Vanperdung/Mandevices_GPS_GSM/Document/stm32f103 pinout.jpg

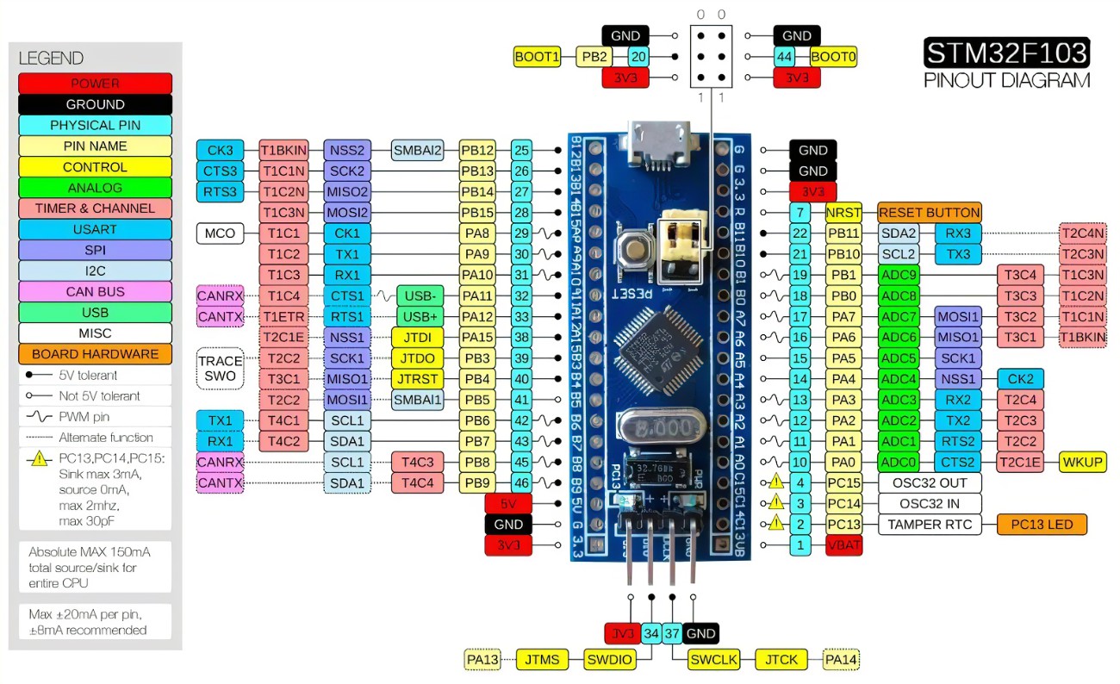
Document/stm32f103 pinout.jpg
