Vanperdung/Mandevices_GPS_GSM/HARDWARE/MandevicesGPSGSM/PCB1.PcbDoc.htm

Reporting Options

# File in Previous Format

Date | : | 3/28/2022
Time | : | 7:57:32 PM
Filename | : | D:\Mandevices_GPS_GSM\Mandevices_GPS_GSM\Hardware\MandevicesGPSGSM\PCB1.PcbDoc

Version | Warning

This file was generated by an earlier version of the software
