Vanperdung/Mandevices_GPS_GSM/Document/so-do-mach-USB-to-TTL-CH340G.png

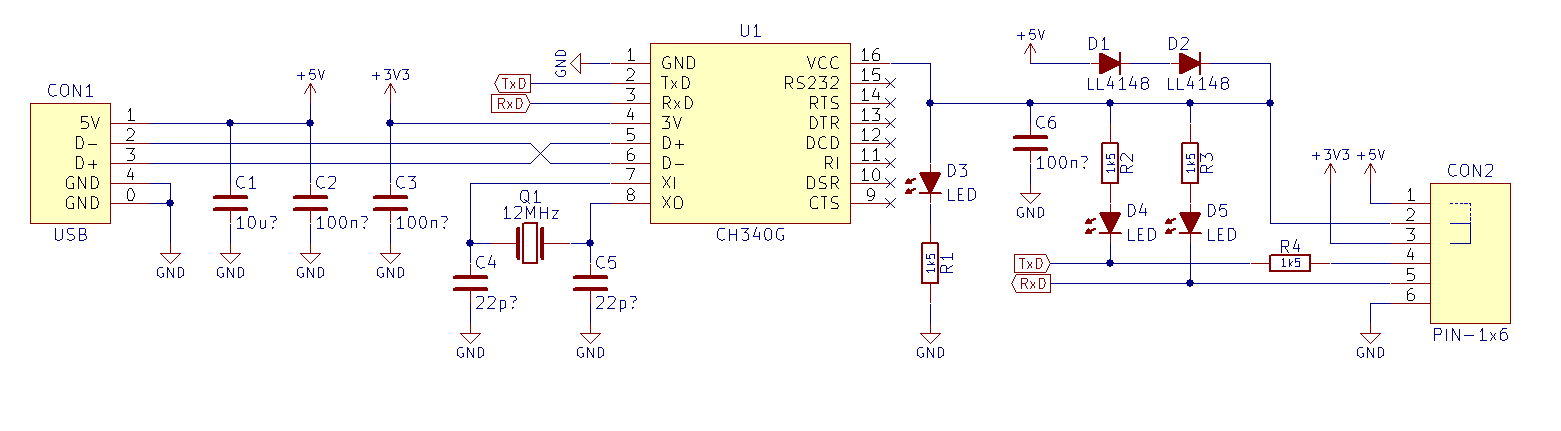
Document/so-do-mach-USB-to-TTL-CH340G.png
