Vanperdung/Mandevices_GPS_GSM/Document/DATN-master/List linh kien/BOM List - New.xlsx

Comment | Description | Designator | Footprint | LibRef | Quantity | Check | Còn lại | Cần mua thêm | Nơi mua | Mã SP | ghi chú
PIN 3V | Battery 3VDC | BT1, BT2 | CR1220 SMD | PIN 3V | 2 | v | 0 | 2 | lkcl | PIN0001 | cái
100uF/100V | Cap 100uF/35V - 470uF/16V | C1, C2 | CP1.5/3.4 | CP3 | 2 | v | 2 | 2 | lkcl | CLA4515 | cái
5D330K 33V | 5D330K 33V | C3 | CN2 | CN | 1 | v | 6 | 0 |  |  | cái
104 | Cap SMD | C4, C20, C22, C24, C26, C28, C31, C38, C48, C53 | C0603 SMT | CM_1, CM | 10 | v |  | 2 | lkcl | CLA4098 | dây 10 con
47uF | Cap SMD | C5, C6 | SM-1210 | CM_1 | 2 | v | 3 | 2 | cxt | A072302 | con
1uF | Cap SMD | C7, C8, C35, C36, C37, C40 | CAP_0805 | CM_1, CM | 6 | v |  | 1 | lkcl | CLA3548 | dây
2.2uF/100V | CAP CER 2.2UF 100V X7R 1210 445-4498-2-ND | C9, C10, C13 | SM-1210 | CM | 3 | v | 2 | 5 | cxt | A101901 | con
39pF | Cap SMD | C11 | CAP_0805 | CM_1 | 1 | v | nhiều
6800pF | Cap SMD | C12 | CAP_0805 | CM_1 | 1 | v | nhiều
104 | Cap SMD | C14, C44, C46, C52, C54 | CAP_0805 | CM_1, CM | 5 | v | nhiều
10uF/25V | Cap SMD | C15, C16 | CAP_0805 | CM_1 | 2 | v | 1 | 1 | lkcl | CLA4020 | dây 10 con
10uF/16V | Cap SMD | C17, C18 | CAP_0805 | CM_1 | 2
1uF | Cap SMD | C19, C32 | C0603 SMT | CM | 2 | v | 1 | 1 | lkcl | CLA4103 | dây 10 con
10uF | Cap SMD | C21, C23, C25, C27 | C0603 SMT | CM | 4 | v | 0 | 1 | lkcl | CLA4107 | dây 10 con
22pF | Cap SMD | C29, C30, C47 | C0603 SMT | CM | 3 | v | nhiều
10pF | Cap SMD | C33, C34 | C0603 SMT | CM | 2 | v | 0 | 1 | lkcl | CLA1296 | dây 10 con
2.2uF | Cap SMD | C39 | RES-SMD-1210 | CM | 1
470uF/6V3 | Cap Aluminum | C41, C42 | C_Alu_6.3x7.7 | C-Alu-Tantalum | 2 | v | 0 | 4 | lkcl | CLA1037 | cái
100uF/16V | Cap Tantalum 7343 | C43 | C_7343_40 | C-Alu-Tantalum | 1 | v | 1 | 2 | lkcl | CLA1291 | cái
10nF | Cap SMD | C45 | CAP_0805 | CM | 1 | v | nhiều
NM | Cap SMD | C49, C50 | C0603 SMT | CM | 2
4.uF | Cap SMD | C51 | SM-1210 | CM | 1 | v | 0 | 2 | cxt | A132403 | con
10uF | Cap SMD | C52 | CAP_0805 | CM | 1
100pF | Capacitor, Cap SMD | C55, C56 | CAP_0805 | CapSMD, CM | 2 | v | 0 | 1 | lkcl | CLA1309 | dây 10 con
B560C-13-F | DIODE SCHOTTKY 60V 5A SMC | D1, D3 | DO-214AB SMC | D5A | 2 | v | 0 | 4 | banlinhkien |  | con | https://banlinhkien.com/diode-ss56-5a-60v-smc-do214ab-p12911888.html
B340-13-F | DIODE SCHOTTKY 40V 3A SMC, Diode 1A | D2, D9, D10 | DO-214AB SMA | D1A | 3 | v | 0 | 10 | lkcl | CLA2548 | con
PWR_12V | LED Single colour Green and Red | D4 | LED-0805-Yellow | LED | 1 | v | 1 |  |  |  | dây 10 con
PWR_4V | LED Single colour Green and Red | D5 | LED-0805-Green | LED | 1 | v | 1 |  |  |  | dây 10 con
DIODE-BAV99 | ZENER, SOT23, | D6, D7, D11 | SOT23 | DIODE-BAV99 | 3 | v | 7 | 10 | lkcl | CL00319 | con
V_IN | LED Single colour Green and Red | D8 | LED-0805-Red | LED | 1 | v | nhiều
RKEF300HF-ND | PTC RESET FUSE 60V 3A RADIAL | F1 | FUSE2 | Fuse | 1 | v | 2
F1A | Fuse | F2 | RES-SMD-1812 | Fuse | 1 | v | 0 | 2 | lkcl | CLA1687 | cái
BLM21PG600SN1D | Ferrite Bead | FB1, FB2, FB3, FB4, FB5 | R0805 | Ferrite Bead | 5 | v | 0 | 2 | lkcl | CLA3470 | dây 10 con
watdog | Jumper 2 | J1 | JP2 | JP 2 | 1
ST_LINK | Header IDC, 4 x 1 Pin Vertical 2.54mm Pitch (Non-Boxed, Male) | J2 | CON_4P | Header4 | 1
BOOT | Connector 3x2 | J3 | JP3x2 | JP3x2 | 1
DEBUG | Jumper 3 | J4 | JP3 | JP3 | 1
GPS_ANTENNA |  | J5, J9 | Antenna-MCX5.08-H5 | ANTEN | 2 | v | 0 | 4 | lkcl | CLA5149 | cái
GSM |  | J6 | Antenna-IPEX | ANTEN | 1
SIM MICRO PUSH |  | J7 | MICRO_SIM_HOLDER | SIM MICRO PUSH | 1 | v | 2
RS485 | Header 2 (Green) | J10 | Hed2V_3.96 | Hed2 | 1 | v | 0 | 2 | lkcl | CLA3094 | cái
PWR | Header 4 (Green) | J11 | Hed4V_3.96 | Hed4 | 1 | v | 0 | 2 | lkcl | CLA3093 | cái
PWR OUT | Connector 4 | J12 | CON_2.54mm_4 | Con4 | 1
NPN_SENSOR | Connector 4 | J13 | CON_2.54mm_4 | Con4 | 1
V_IN | Connector 2 | J14 | CON_2.54mm_2 | Con2 | 1
Header3 | Header IDC, 3 x 1 Pin Vertical 2.54mm Pitch (Non-Boxed, Male) | J15 | Header3 | Header3 | 1
DHT11 |  | J16 | DHT11 | DHT11 | 1
L | Inductor | L1 | L2 UF9.8 | L2x220 | 1 | v | 3
6.8uH | FIXED IND 6.2UH 5.7A 22.4 MOHM | L2 | L01 SMD 12*12*6 | L1 | 1 | v | 0 | 2 | lkcl | CLA2641 | cái
47nH | Inductor | L3 | C0805 | L1 | 1 | v | 1 |  |  |  | dây 10 con
100uH | 100uH 0805 | L4 | R0805 | Ferrite Bead | 1
OLED 1.3 |  | LCD1 | OLED 1.3 | OLED 1.3 | 1
LED | LED Single colour Green and Red | LED1 | LED-0805-Green | LED | 1
LED | LED Single colour Green and Red | LED2 | LED-0805-Yellow | LED | 1
LED | LED Single colour Green and Red | LED3 | LED-0805-Red | LED | 1
SIM800C |  | M1 | SIM800C | SIM800C | 1 | v | 2
C1815 | NPN 600mW, ECB | Q1, Q2, Q3, Q4, Q5, Q6 | SOT23B | C1815 | 6 | v | 4 | 10 | lkcl | CL00356 | cái
10K | Resistor SMD | R1, R3, R7, R19, R28, R29, R30, R55, R59, R60 | RES-SMD-0805 | RM | 10
22K | Resistor SMD | R2, R4 | RES-SMD-0805 | RM | 2
100K | Resistor SMD | R5, R8, R9, R41, R42 | RES-SMD-0805 | RM | 5
1K | Resistor SMD | R6, R13, R14, R15, R16, R36, R39, R40, R43, R61 | RES-SMD-0805 | RM | 10
4.7K | Resistor SMD | R10, R62, R65 | RES-SMD-0805 | RM | 3
47K | Resistor SMD | R11 | RES-SMD-0805 | RM | 1
4k7 | Resistor SMD | R12 | RES-SMD-0805 | RM | 1
0R | Resistor SMD | R17, R52, R56, R58 | RES-SMD-0805 | RM | 4
10R | Resistor SMD | R18, R23, R25 | RES-SMD-0805 | RM | 3
22R | Resistor SMD | R20, R26 | RES-SMD-0603 | RM | 2 | v | 0 | 1 | lkcl | CLA3271 | dây 50 con
10K | Resistor SMD | R21, R22, R53, R54 | R0603 -SMT | RM | 4
10K | Resistor SMD | R24 | RES-SMD-0603 | RM | 1
1k | Resistor SMD | R27 | RES-SMD-0603 | RM | 1
1K | Resistor SMD | R31, R35, R37, R49, R50 | R0603 -SMT | RM | 5
47K | Resistor SMD | R32, R51 | R0603 -SMT | RM | 2
4.7K | Resistor SMD | R33, R34, R38 | R0603 -SMT | RM | 3
51R | Resistor SMD | R44, R45, R46 | R0603 -SMT | RM | 3
0R | Resistor SMD | R47, R48 | R0603 -SMT | RM | 2
120R | Resistor SMD | R57 | RES-SMD-0805 | RM | 1
1K 1% | Resistor SMD | R63 | RES-SMD-0805 | RM | 1
10K 1% | Resistor SMD | R64 | RES-SMD-0805 | RM | 1
10k | Resistor SMD | R66 | R0805 | RM | 1
RFID |  | RFID1 | RFID RC522 | RFID RC522 | 1 | v | 1
SW-SMD | Switch | S1 | SW-SMD | SW-SMD | 1 | v | 9
SW-SMD | Switch | S2, S3, S4 | BUTTON NGHIENG | SW-SMD | 3 | v | 0 | 10 | lkcl | CLA4187 | con
TLV70233DBVT |  | U1 | TLV70233_3.3V | TLV70233_3.3V | 1 | v | 1 | 1 | cxt | A041602 | con
TPS54360DDA | REG BUCK SPLIT RAIL 8SOPWRPAD | U2 | DDA8_3P1X2P4-M | TPS54360DDA | 1 | v | 2
TLV1117-33CDCYR | 3v3 | U3 | SOT223-4N | LM1117 | 1 | v | nhiều
LM7812SX/NOPB | LM7812SX/NOPB | U4 | TO-263-4 | LM78xx_1 | 1 | v | 3
78M05 | On ap +, from + 5 to + 24VDC | U5 | TO252-3L | LM78xx | 1 | v | 2
STM32F103RCT6 | MCU 32BIT 256KB FLASH 64LQFP | U6 | LQFP-64 | STM32F103RCT6 | 1 | v | 2 |  |  |  |  | thay bằng stm32f107rc
TPS3828 |  | U7 | TPS3828 | TPS3828 | 1
SRV05 | TVS DIODE 5V | U8 | SOT23-6 | SRV05 | 1 | v | 4
GPS L70 |  | U9 | GPS L70 | GPS L70 | 1 | v | 2
SMF05C | ESD Protection | U10 | SOT_363_6 | SMF05C | 1 | v | 0 | 2 | cxt | A071806 | con
AT24C256 |  | U11 | SO-8 | AT24Cxx | 1 | v | 1
SN75176A |  | U12 | SN75176A | SN75176A | 1 | v | 4
PC817 | Single Opto | U13 | DIP4/W0.3 | PC817 | 1 | v | 0 | 2 | lkcl | CL00800 | con
USB |  | USB | USB-B-Mini | USB-M | 1 | v | 0 | 4 | lkcl | CLA1971 | con
32,768 Khz | Crystal 32,768kHz for timer real | X1 | XT32kn | XT32k | 1 | v | 0 | 2 | lkcl | CLA1612 | con
8MHz | CRYSTAL 16MHZ 18PF SMD | Y1 | ABM7_v1_1_BIG | ABM7-16.000MHZ-D2Y-T | 1 | v | 4
