Vanperdung/Mandevices_GPS_GSM/Document/DATN-master/List linh kien/BOM list.xlsx

Comment | Description | Designator | Footprint | LibRef | Quantity | Check | Price | total Price | link | note | code | Số lượng | Cửa hàng
PIN 3V | Battery 3VDC | BT1, BT2 | CR1220 SMD | PIN 3V | 2 | ok | VND 3000 | VND 6000 | http://linhkienchatluong.vn/pin-cac-loai/pin-cr1220-lithium_sp540_ct5222.aspx | Pin Cr1220 smd | PIN0071 | 2 cái | lkcl
100uF/100V | Cap 100uF/35V - 470uF/16V | C1, C2 | CP1.5/3.4 | CP3 | 2 | ok | VND 500 | VND 1000 | http://linhkienchatluong.vn/tu-hoa-co-phan-cuc/tu-hoa-35v-100uf-6x12mm-tan-so-cao_sp454_ct928.aspx | tụ hóa 100uf/35v | CLA0955 | 2 con | lkcl
5D330K 33V | 5D330K 33V | C3 | CN2 | CN | 1 | ok | VND 1000 | VND 1000 | http://linhkienchatluong.vn/tu-chong-set---varistor/tu-chong-set-varistor-5d330k-33v-5mm_sp1161_ct7521.aspx | varistor 5d330k 33V | CLA1205 | 1 con | lkcl
104 | Cap SMD | C4, C20, C22, C24, C26, C28, C31, C43, C47, C48 | C0603 SMT | CM_1, CM | 10 | ok | VND 200 | VND 2000 | http://linhkienchatluong.vn/tu-dan-060308051206/tu-dan-0603-du-gia-tri-tu-1pf-den-22uf-10c_sp1063_ct7503.aspx | tụ 0603 104 | CLA4098 | 1 dây 10 con | lkcl
47uF | Cap SMD | C5, C6 | SM-1210 | CM_1 | 2 | ok | VND 1500 | VND 3000 | https://linhkien.cxt.vn/2518-tu-47uf-10v-1210.html | Tụ 47uF SMD1210 | A072302 | mua 5 con | cxt | v
1uF | Cap SMD | C7, C8, C35 | CAP_0805 | CM_1, CM | 3 | ok | VND 350 | VND 1050 | http://linhkienchatluong.vn/tu-dan-060308051206/tu-dan-0805-du-gia-tri-tu-1pf-den-10uf-10c_sp1063_ct7504.aspx | tụ 0805 1uF | CLA3548 | 1 dây 10 con | lkcl
2.2uF/100V | CAP CER 2.2UF 100V X7R 1210 445-4498-2-ND | C9, C10, C13 | SM-1210 | CM | 3 | ok | VND 1000 | VND 3000 | https://linhkien.cxt.vn/4174-tu-22uf-50v-1210.html | tụ 2.2uF SMD1210 | A101901 | mua 5 con | cxt | v
39pF | Cap SMD | C11 | CAP_0805 | CM_1 | 1 | ok | VND 400 | VND 400 | https://banlinhkien.com/tu-0805-39pf-5-50v-10c-p8232171.html | tụ 0805 39pF | MH009986 | 1 dây 10 con | minhha
6800pF | Cap SMD | C12 | CAP_0805 | CM_1 | 1 | ok | VND 200 | VND 200 | http://linhkienchatluong.vn/tu-dan-060308051206/tu-dan-0805-du-gia-tri-tu-1pf-den-10uf-10c_sp1063_ct7504.aspx | tụ 0805 6.8nF | CLA3538 | 1 dây 10 con | lkcl
104 | Cap SMD | C14, C39, C41, C49 | CAP_0805 | CM_1, CM | 4 | ok | VND 300 | VND 1200 | http://linhkienchatluong.vn/tu-dan-060308051206/tu-dan-0805-du-gia-tri-tu-1pf-den-10uf-10c_sp1063_ct7504.aspx | tụ 0805 100nF - 104 | CLA3544 | 1 dây 10 con | lkcl
10uF/25V | Cap SMD | C15, C16 | CAP_0805 | CM_1 | 2 | ok | VND 500 | VND 1000 | http://linhkienchatluong.vn/tu-dan-060308051206/tu-dan-0805-du-gia-tri-tu-1pf-den-10uf-10c_sp1063_ct7504.aspx | tụ 0805 10uF - 106 | CL07051 | 1 dây 10 con | lkcl
10uF/16V | Cap SMD | C17, C18 | CAP_0805 | CM_1 | 2 | ok | VND 500 | VND 1000 | http://linhkienchatluong.vn/tu-dan-060308051206/tu-dan-0805-du-gia-tri-tu-1pf-den-10uf-10c_sp1063_ct7504.aspx | tụ 0805 10uF - 106 | CL07051 |  | lkcl
1uF | Cap SMD | C19, C32, C46 | C0603 SMT | CM | 3 | ok | VND 300 | VND 900 | http://linhkienchatluong.vn/tu-dan-060308051206/tu-dan-0805-du-gia-tri-tu-1pf-den-10uf-10c_sp1063_ct7504.aspx | tụ 0603 1uF - 105 | CLA4103 | 1 dây 10 con | lkcl
10uF | Cap SMD | C21, C23, C25, C27 | C0603 SMT | CM | 4 | ok | VND 300 | VND 1200 | http://linhkienchatluong.vn/tu-dan-060308051206/tu-dan-0805-du-gia-tri-tu-1pf-den-10uf-10c_sp1063_ct7504.aspx | tụ 0603 10uF - 106 | CLA4107 | 1 dây 10 con | lkcl
22pF | Cap SMD | C29, C30, C42 | C0603 SMT | CM | 3 | ok | VND 200 | VND 600 | http://linhkienchatluong.vn/tu-dan-060308051206/tu-dan-0805-du-gia-tri-tu-1pf-den-10uf-10c_sp1063_ct7504.aspx | tụ 0603 22pF | CLA1297 | 1 dây 10 con | lkcl
10pF | Cap SMD | C33, C34 | C0603 SMT | CM | 2 | ok | VND 200 | VND 400 | http://linhkienchatluong.vn/tu-dan-060308051206/tu-dan-0805-du-gia-tri-tu-1pf-den-10uf-10c_sp1063_ct7504.aspx | tụ 0603 10pF | CLA1296 | 1 dây 10 con | lkcl
470uF/6V3 | Cap Aluminum | C36, C37 | C_Alu_6.3x7.7 | C-Alu-Tantalum | 2 | ok | VND 1500 | VND 3000 | http://linhkienchatluong.vn/tu-nhom---tu-hoa-dan/tu-nhom-63v-470uf-63x77mm_sp455_ct2878.aspx | tụ nhôm 470uF/6V3 | CLA1037 | 2 Con | lkcl
100uF/16V | Cap Tantalum 7343 | C38 | C_7343_40 | C-Alu-Tantalum | 1 | ok | VND 3500 | VND 3500 | http://linhkienchatluong.vn/tu-tantalium/tu-tantalum-7343-107c-16v-100uf-73x43mm_sp460_ct1165.aspx | tụ tantalum 7343 100uF/16v | CLA1291 | 1 con | lkcl
10nF | Cap SMD | C40 | CAP_0805 | CM | 1 | ok | VND 200 | VND 200 | http://linhkienchatluong.vn/tu-dan-060308051206/tu-dan-0805-du-gia-tri-tu-1pf-den-10uf-10c_sp1063_ct7504.aspx | Tụ 0805 10nF - 103 | CLA3539 | 1 dây 10 con | lkcl
NM | Cap SMD | C44, C45 | C0603 SMT | CM | 2 |  |  | VND 0
100pF | Capacitor, Cap SMD | C50, C51 | CAP_0805 | CapSMD, CM | 2 | ok | VND 300 | VND 600 | http://linhkienchatluong.vn/tu-dan-060308051206/tu-dan-0805-du-gia-tri-tu-1pf-den-10uf-10c_sp1063_ct7504.aspx | Tụ 0805 10pF - 101 | CLA1309 | 1 dây 10 con | lkcl
B560C-13-F | DIODE SCHOTTKY 60V 5A SMC | D1, D3 | DO-214AB SMC | D5A | 2 | ok | VND 2500 | VND 5000 | https://banlinhkien.com/diode-ss56-5a-60v-smc-do214ab-p12911888.html | Diode SS56 |  | mua 2 con | minhha
B340-13-F | DIODE SCHOTTKY 40V 3A SMC, Diode 1A | D2, D10, D11 | DO-214AB SMA | D1A | 3 | ok | VND 500 | VND 1500 | http://linhkienchatluong.vn/diode-schottky/ss36-sr360-diode-schottky-3a-60v-sma-do-214ac_sp571_ct4342.aspx | Diode SS36 | CLA2548 | 3 con | lkcl
PWR_12V | LED Single colour Green and Red | D4 | LED-0805-Yellow | LED | 1 | ok | VND 250 | VND 250 | http://linhkienchatluong.vn/led-dan-0603-0805-1206/led-dan-0805-du-cac-mau-10c_sp1083_ct7619.aspx | led 0805 vàng | CLA3136 | 1 dây 10 con | lkcl
PWR_4V | LED Single colour Green and Red | D5 | LED-0805-Green | LED | 1 | ok | VND 250 | VND 250 | http://linhkienchatluong.vn/led-dan-0603-0805-1206/led-dan-0805-du-cac-mau-10c_sp1083_ct7619.aspx | led 0805 xanh lá | CL07351 | 1 dây 10 con | lkcl
DIODE-BAV99 | ZENER, SOT23, | D6, D7, D12 | SOT23 | DIODE-BAV99 | 3 | ok | VND 500 | VND 1500 | http://linhkienchatluong.vn/diode-fast-recover/bav99-a7w-02a-70v-ultra-fast-diodes-sot-23-chinh-hang-nxp_sp592_ct407.aspx | Diode BAV99 | CL00319 | Mua 10 con | lkcl
GPS | LED Single colour Green and Red | D8 | LED-0805-Red | LED | 1 | ok | VND 500 | VND 500 | http://linhkienchatluong.vn/led-dan-0603-0805-1206/led-dan-0805-du-cac-mau-10c_sp1083_ct7619.aspx | led 0805 red | CLA3133 | 1 dây 10 con | lkcl
1N5819 | Diode 1A | D9 | SOD123 | D1A | 1 | ok | VND 200 | VND 200 | http://linhkienchatluong.vn/diode-chinh-luu/1n5819-s4-diode-schottky-1a-40v-sot-123-1206-10c_sp572_ct9315.aspx | diode S4 | CL06953 | 1 dây 10 con | lkcl
RKEF300HF-ND | PTC RESET FUSE 60V 3A RADIAL | F1 | FUSE2 | Fuse | 1 | ok | VND 3000 | VND 3000 | http://linhkienchatluong.vn/cau-chi-tu-phuc-hoi-ptc/cau-chi-tu-phuc-hoi-3a-72v-rxef300-ptc_sp845_ct2443.aspx | Cầu chì tự phục hồi 3A/72V | CLA1671 | 1 cái | lkcl
BLM21PG600SN1D | Ferrite Bead | FB1, FB2, FB3, FB4, FB5 | R0805 | Ferrite Bead | 5 | ok | VND 500 | VND 2500 | http://linhkienchatluong.vn/cuon-cam-dan-060308051206/cuon-cam-dan-0805-100uh-10c_sp1059_ct4758.aspx | Cuộn cảm 0805 100uH | CLA3470 | 1 dây 10 con | lkcl
watdog | Jumper 2 | J1 | JP2 | JP 2 | 1 |  |  | VND 0
BOOT | Connector 3x2 | J2 | JP3x2 | JP3x2 | 1 |  |  | VND 0
ST_LINK | Header IDC, 4 x 1 Pin Vertical 2.54mm Pitch (Non-Boxed, Male) | J3 | CON_4P | Header4 | 1 | ok | VND 200 | VND 200 | http://linhkienchatluong.vn/header-xh254-trang/header-duc-4p-xh254-4p-chan-thang-10c_sp861_ct1713.aspx | Header 4p Đực cắm thẳng | CLA1880 | 1 túi 10 con | lkcl
DEBUG | Jumper 3 | J4 | JP3 | JP3 | 1 |  |  | VND 0
GPS_ANTENNA |  | J5, J9 | Antenna-MCX5.08-H5 | ANTEN | 2 | ok | VND 7000 | VND 14000 | http://linhkienchatluong.vn/de-anten/de-anten-sma-5-chan-cai-cong-sma-kwe_sp1035_ct8355.aspx | Đế Anten SMA 5 chân | CLA5149 | 2 cái | lkcl
GSM + GPS |  | J6, J8 | Antenna-IPEX | ANTEN | 1 | ok | VND 1800 | VND 1800 | http://linhkienchatluong.vn/de-anten/de-anten-ufl-r-smt-ipexipx-loai-dan_sp1035_ct8585.aspx | Đế anten ipx dán | CL06450 | 2 cái | lkcl
SIM MICRO PUSH |  | J7 | MICRO_SIM_HOLDER | SIM MICRO PUSH | 1 | ôk | VND 5000 | VND 0 | http://linhkienchatluong.vn/khe-the-nho-khe-sim/socket-microsim-6p-nhan-thao-sim-khe-microsim_sp732_ct7161.aspx | Khe SIM micro | CLA4915 | 1 cái | lkcl
RS485 | Header 2 (Green) | J10 | Hed2V_3.96 | Hed2 | 1 | ok | VND 300 | VND 300 | http://linhkienchatluong.vn/header-vh396/header-duc-2p-vh396-2p-chan-thang_sp866_ct1695.aspx | Header 2p 3.96 thẳng | CLA1918 | 3 cái | lkcl
PWR | Header 4 (Green) | J11 | Hed4V_3.96 | Hed4 | 1 | ok | VND 500 | VND 500 | http://linhkienchatluong.vn/header-vh396/header-duc-4p-vh396-4p-chan-thang_sp866_ct1697.aspx | Header 4p 3.96 thẳng | CLA1920 | 2 cái | lkcl
PWR OUT | Connector 4 | J12 | CON_2.54mm_4 | Con4 | 1 |  |  | VND 0
NPN_SENSOR | Connector 4 | J13 | CON_2.54mm_4 | Con4 | 1 |  |  | VND 0
V_IN | Connector 2 | J14 | CON_2.54mm_2 | Con2 | 1 |  |  | VND 0
Header3 | Header IDC, 3 x 1 Pin Vertical 2.54mm Pitch (Non-Boxed, Male) | J15 | Header3 | Header3 | 1 |  |  | VND 0
DHT11 |  | J16 | DHT11 | DHT11 | 1 | OK | VND 23000 | VND 23000 | http://linhkienchatluong.vn/cam-bien-nhiet-do---do-am/cam-bien-nhiet-do-do-am-dht11_sp509_ct3398.aspx | Cảm biến DHT11 | CB00022 | 1 cái | lkcl
L | Inductor |  | L2 UF9.8 | L2x220 | 1 | ok | VND 8000 | VND 8000 | https://banlinhkien.com/cuon-loc-5mh-13x8x5mm-p12117065.html | Cuộn lọc 5mH Cuộn Lọc 3.3mH UU9.8 UF9.8 | MH003418 MH010822 | mỗi loại 1 cái | minhha
6.8uH | FIXED IND 6.2UH 5.7A 22.4 MOHM | L2 | L01 SMD 12*12*6 | L1 | 1 | ok | VND 3000 | VND 3000 | http://linhkienchatluong.vn/cuon-cam-dan-cd127-12x12x7mm/cuon-cam-dan-cdrh127-68uh-6r8-3a-12x12x7mm_sp842_ct3448.aspx | Cuộn cảm CDRH127 6.8uH | CLA2641 | 1 cái | lkcl
47nH | Inductor | L3 | C0805 | L1 | 1 | ok | VND 400 | VND 400 | https://linhkien.cxt.vn/2829-cuon-cam-47nh-0805-10c.html | Cuộn cảm 0805 47nH | A092301 | 1 túi 10 con | cxt | v
100uH | 100uH 0805 | L4 | R0805 | Ferrite Bead | 1 |  |  | VND 0
OLED 1.3 |  | LCD1 | OLED 1.3 | OLED 1.3 | 1 | ok | VND 145000 | VND 145000 | https://banlinhkien.com/vn-man-hinh-oled-1.3-128x64-i2c-xanh-oled13i2cb-p12496195.html | Màn OLED 1.3 I2C | MH010983 | 1 Cái | minhha
LED | LED Single colour Green and Red | LED1 | LED-0805-Green | LED | 1 |  |  | VND 0
LED | LED Single colour Green and Red | LED2 | LED-0805-Yellow | LED | 1 |  |  | VND 0
LED | LED Single colour Green and Red | LED3 | LED-0805-Red | LED | 1 |  |  | VND 0
SIM800C |  | M1 | SIM800C | SIM800C | 1 | ok | VND 100000 | VND 100000 | https://linhkien.cxt.vn/1447-sim800c-24mb-bluetooth.html | SIM800C | A042402 | 1 cái | cxt | v
C1815 | NPN 600mW, ECB | Q1, Q2, Q3, Q4, Q5, Q6 | SOT23B | C1815 | 6 | ok | VND 400 | VND 2400 | http://linhkienchatluong.vn/transistor/c1815-hf-npn-transistor-015a-60v-sot-23-chinh-hang-jcet_sp787_ct8501.aspx | tran C1815 smd | CL06381 | mua 10 con | lkcl
10K | Resistor SMD | R1, R3, R7, R21, R46, R50, R51 | RES-SMD-0805 | RM | 7 | ok | VND 60 | VND 420 | http://linhkienchatluong.vn/dien-tro-dan-0805-18w/dien-tro-dan-0805-10k-1-50c_sp837_ct5370.aspx | Trở 0805 10k 1% | CLA3322 | 1 dây 50 con | lkcl
22K | Resistor SMD | R2, R4 | RES-SMD-0805 | RM | 2 | ok | VND 60 | VND 120 | http://linhkienchatluong.vn/dien-tro-dan-0805-18w/dien-tro-dan-0805-22k-1-50c_sp837_ct5378.aspx | Trở 0805 22k 1% | CLA3327 | 1 dây 50 con | lkcl
100K | Resistor SMD | R5, R8, R9, R33, R34 | RES-SMD-0805 | RM | 5 | ok | VND 60 | VND 300 | http://linhkienchatluong.vn/dien-tro-dan-0805-18w/dien-tro-dan-0805-100k-1-50c_sp837_ct8463.aspx | Trở 0805 100k 1% | CL05806 | 1 dây 50 con | lkcl
1K | Resistor SMD | R6, R13, R14, R15, R16, R28, R31, R32, R35, R52 | RES-SMD-0805 | RM | 10 | ok | VND 60 | VND 600 | http://linhkienchatluong.vn/dien-tro-dan-0805-18w/dien-tro-dan-0805-1k-1-50c_sp837_ct5346.aspx | Trở 0805 1k 1% | CLA3303 | 1 dây 50 con | lkcl
4.7K | Resistor SMD | R10, R53, R56 | RES-SMD-0805 | RM | 3 | ok | VND 60 | VND 180 | http://linhkienchatluong.vn/dien-tro-dan-0805-18w/dien-tro-dan-0805-47k-1-50c_sp837_ct5362.aspx | Trở 0805 4.7k 1% | CLA3314 | 1 dây 50 con | lkcl
47K | Resistor SMD | R11 | RES-SMD-0805 | RM | 1 | ok | VND 60 | VND 60 | http://linhkienchatluong.vn/dien-tro-dan-0805-18w/dien-tro-dan-0805-47k-1-50c_sp837_ct5386.aspx | Trở 0805 47k 1% | CLA3335 | 1 dây 50 con | lkcl
4k7 | Resistor SMD | R12 | RES-SMD-0805 | RM | 1 |  |  | VND 0
10R | Resistor SMD | R17, R20, R22 | RES-SMD-0805 | RM | 3 | ok | VND 60 | VND 180 | http://linhkienchatluong.vn/dien-tro-dan-0805-18w/dien-tro-dan-0805-10r-1-50c_sp837_ct5295.aspx | Trở 0805 10R 1% | CL05777 | 1 dây 50 con | lkcl
10K | Resistor SMD | R18, R19, R44, R45 | R0603 -SMT | RM | 4 | ok | VND 40 | VND 160 | http://linhkienchatluong.vn/dien-tro-dan-0603-116w/dien-tro-dan-0603-10k-1-50c_sp836_ct5792.aspx | Trở 0603 10k 1% | CLA0759 | 1 dây 50 con | lkcl
1K | Resistor SMD | R23, R27, R29, R41, R42 | R0603 -SMT | RM | 5 | ok | VND 40 | VND 200 | http://linhkienchatluong.vn/dien-tro-dan-0603-116w/dien-tro-dan-0603-1k-1-50c_sp836_ct5772.aspx | Trở 0603 1k 1% | CLA0742 | 1 dây 50 con | lkcl
47K | Resistor SMD | R24, R43 | R0603 -SMT | RM | 2 | ok | VND 40 | VND 80 | http://linhkienchatluong.vn/dien-tro-dan-0603-116w/dien-tro-dan-0603-47k-1-50c_sp836_ct8437.aspx | Trở 0603 47k 1% | CL06093 | 1 dây 50 con | lkcl
4.7K | Resistor SMD | R25, R26, R30 | R0603 -SMT | RM | 3 | ok |  | VND 0 | http://linhkienchatluong.vn/dien-tro-dan-0603-116w/dien-tro-dan-0603-47k-1-50c_sp836_ct5784.aspx | Trở 0603 4.7k 1% | CL05810 | 1 dây 50 con | lkcl
51R | Resistor SMD | R36, R37, R38 | R0603 -SMT | RM | 3 | ok | VND 40 | VND 120 | http://linhkienchatluong.vn/dien-tro-dan-0603-116w/dien-tro-dan-0603-51r-1-50c_sp836_ct5746.aspx | Trở 0603 51R 1% | CLA0720 | 1 dây 50 con | lkcl
0R | Resistor SMD | R39, R40 | R0603 -SMT | RM | 2 | ok | VND 40 | VND 80 | http://linhkienchatluong.vn/dien-tro-dan-0603-116w/dien-tro-dan-0603-0r-1-50c_sp836_ct5720.aspx | Trở 0603 0R 1% | CLA0702 | 1 dây 50 con | lkcl
0R | Resistor SMD | R47, R49 | RES-SMD-0805 | RM | 2 | ok | VND 60 | VND 120 | http://linhkienchatluong.vn/dien-tro-dan-0805-18w/dien-tro-dan-0805-0r-1-50c_sp837_ct5271.aspx | Trở 0805 0R 1% | CLA0783 | 1 dây 50 con | lkcl
120R | Resistor SMD | R48 | RES-SMD-0805 | RM | 1 | ok | VND 60 | VND 60 | http://linhkienchatluong.vn/dien-tro-dan-0805-18w/dien-tro-dan-0805-120r-1-50c_sp837_ct5321.aspx | Trở 0805 120R 1% | CLA3285 | 1 dây 50 con | lkcl
1K 1% | Resistor SMD | R54 | RES-SMD-0805 | RM | 1 |  |  | VND 0
10K 1% | Resistor SMD | R55 | RES-SMD-0805 | RM | 1 |  |  | VND 0
RFID |  | RFID1 | RFID RC522 | RFID RC522 | 1 | ok | VND 38000 | VND 38000 | http://linhkienchatluong.vn/module-rfrfid/module-rfid-rc522-nfc-1356mhz_sp491_ct192.aspx | Module RFID RC522 | MOD0039 | 1 cái | lkcl
SW-SMD | Switch | S1 | SW-SMD | SW-SMD | 1 | ok | VND 500 | VND 500 | http://linhkienchatluong.vn/nut-nhan-sieu-nho/nut-nhan-2-chan-dan-3x6x25mm-loai-tot-dong-day-10c_sp849_ct1800.aspx | Nút nhấn 2 chân smd | CLA1750 | 1 túi 10 cái | lkcl
TLV70233DBVT |  | U1 | TLV70233_3.3V | TLV70233_3.3V | 1 | ok | VND 4800 | VND 4800 | https://linhkien.cxt.vn/4424-tlv70333dbvr-sot23-5-ic-reg-linear-33v-300ma.html | IC nguồn TLV70333 SOT23 | A041602 | 1 cái | cxt | v
TPS54360DDA | REG BUCK SPLIT RAIL 8SOPWRPAD | U2 | DDA8_3P1X2P4-M | TPS54360DDA | 1 | ok | VND 25000 | VND 25000 | https://linhkien.cxt.vn/1945-tps54360ddar.html | IC nguồn TPS54360 | A082104 | 1 cái | cxt | v
TLV1117-33CDCYR | 3v3 | U3 | SOT223-4N | LM1117 | 1 | ok | VND 1500 | VND 1500 | http://linhkienchatluong.vn/ho-ams--1117/ams1117-33-1a-33v-sot-223_sp1008_ct371.aspx | IC nguồn AMS1117 | CL00249 | mua 5 con | lkcl
LM7812SX/NOPB | LM7812SX/NOPB | U4 | TO-263-4 | LM78xx_1 | 1 | ok | VND 4000 | VND 4000 | http://linhkienchatluong.vn/ic-on-ap-78xx-79xx/l7812cd2t-15a-12v-to-263_sp1000_ct596.aspx | IC nguồn L7812 TO263 | CL00202 | 1 con | lkcl
78M05 | On ap +, from + 5 to + 24VDC | U5 | TO252-3L | LM78xx | 1 | ok | VND 4000 | VND 4000 | http://linhkienchatluong.vn/ic-on-ap-78xx-79xx/78m05-05a-5v-to-252-chinh-hang-st_sp1000_ct8359.aspx | IC nguồn 78M05 TO 252 | CL05925 | 1 con | lkcl
STM32F103RCT6 | MCU 32BIT 256KB FLASH 64LQFP | U6 | LQFP-64 | STM32F103RCT6 | 1 | ok | VND 55000 | VND 55000 | http://linhkienchatluong.vn/stm/stm32f103rct6-lqfp64-chinh-hang-st_sp564_ct752.aspx | MCU STM32F103RCT6 | CL00892 | 1 con | lkcl | Cxt hết hàng
TPS3828 |  | U7 | TPS3828 | TPS3828 | 1 |  |  | VND 0
GPS L70 |  | U8 | GPS L70 | GPS L70 | 1 | ok | VND 135000 | VND 135000 | https://linhkien.cxt.vn/1689-l70-r.html | GPS L70R | A040202 | 1 con | cxt | v
SMF05C | F | U9 | SOT_363_6 | SMF05C | 1 | ok | VND 2500 | VND 2500 | https://linhkien.cxt.vn/1882-smf05ctct-tvs-diode-5v.html | TVS Diode 5v | A060607 | 2 con | cxt | v
AT24C256 |  | U10 | SO-8 | AT24Cxx | 1 | ok | VND 13000 | VND 13000 | https://linhkien.cxt.vn/1264-at24c256n-10su-27.html | EEPROM AT24C256N | A071605 | 1 con | cxt | v
SN75176A |  | U11 | SN75176A | SN75176A | 1 | ok | VND 7000 | VND 7000 | http://linhkienchatluong.vn/ic-giao-tiep--mang/sn75176-sn75176bdr-sop-8-chinh-hang-ti_sp575_ct646.aspx | IC RS485 | CL00876 | 1 con | lkcl | F
PC817 | Single Opto | U12 | DIP4/W0.3 | PC817 | 1 | ok | VND 2000 | VND 2000 | http://linhkienchatluong.vn/elpcpcf/pc817-pc817c-dip-4-chinh-hang-sharp_sp1029_ct725.aspx | Opto PC817 | CL00800 | 1 con | lkcl
32,768 Khz | Crystal 32,768kHz for timer real | X1 | XT32kn | XT32k | 1 | ok | VND 1500 | VND 1500 | http://linhkienchatluong.vn/thach-anh-ong/thach-anh-ong-32768khz-3x8mm_sp613_ct1857.aspx | Thạch anh ống 32768 | CLA1616 | 2 con | lkcl
8MHz | CRYSTAL 16MHZ 18PF SMD | Y1 | ABM7_v1_1_BIG | ABM7-16.000MHZ-D2Y-T | 1 | ok | VND 6000 | VND 6000 | http://linhkienchatluong.vn/cac-loai-thach-anh-khac/thach-anh-8mhz-5032-5x32mm-smd-2p_sp615_ct1170.aspx | Thạch anh 8Mhz 5032 5x3.2mm SMD 2P | CLA1617 | 1 con | lkcl
 |  |  |  |  |  |  |  | VND 647030
