Vanperdung/Mandevices_GPS_GSM/Document/DATN-master/PCB/TrackingGPSV1_4/BOM list.xlsx

Comment | Description | Designator | Footprint | LibRef | Quantity
PIN 3V | Battery 3VDC | BT1, BT2 | CR1220 SMD | PIN 3V | 2
100uF/100V | Cap 100uF/35V - 470uF/16V | C1, C2 | CP1.5/3.4 | CP3 | 2
5D330K 33V | 5D330K 33V | C3 | CN2 | CN | 1
104 | Cap SMD, Capacitor | C4, C56, C57, C58, C59, C60, C62, C63 | CAP_0603 | CM_1, CapSMD | 8
47uF | Cap SMD | C5, C6 | SM-1210 | CM_1 | 2
1uF | Cap SMD | C7, C8 | CAP_0805 | CM_1 | 2
2.2uF/100V | CAP CER 2.2UF 100V X7R 1210 445-4498-2-ND | C9, C10, C13 | SM-1210 | CM | 3
39pF | Cap SMD | C11 | CAP_0805 | CM_1 | 1
6800pF | Cap SMD | C12 | CAP_0805 | CM_1 | 1
104 | Cap SMD | C14, C42, C44, C51 | CAP_0805 | CM_1, CM | 4
10uF/25V | Cap SMD | C15, C16 | CAP_0805 | CM_1 | 2
10uF/16V | Cap SMD | C17, C18 | CAP_0805 | CM_1 | 2
1uF | Cap SMD | C19, C30, C32, C35, C37, C38 | C0603 SMT | CM | 6
104 | Cap SMD | C20, C22, C24, C26, C28, C29, C46, C52, C53, C54, C55 | C0603 SMT | CM | 11
10uF | Cap SMD | C21, C23, C25, C27 | C0603 SMT | CM | 4
22pF | Cap SMD | C31, C33, C45 | C0603 SMT | CM | 3
10pF | Cap SMD | C34, C36 | C0603 SMT | CM | 2
470uF/6V3 | Cap Aluminum | C39, C40 | C_Alu_6.3x7.7 | C-Alu-Tantalum | 2
100uF/16V | Cap Tantalum 7343 | C41 | C_7343_40 | C-Alu-Tantalum | 1
10nF | Cap SMD | C43 | CAP_0805 | CM | 1
10uF | Cap SMD | C47 | CAP_0805 | CM | 1
NM | Cap SMD | C48, C49 | C0603 SMT | CM | 2
4.uF | Cap SMD | C50 | SM-1210 | CM | 1
10uF | Capacitor | C61 | CAP_0603 | CapSMD | 1
22pF | Capacitor | C64, C65 | CAP_0603 | CapSMD | 2
100pF | Capacitor, Cap SMD | C66, C67 | CAP_0805 | CapSMD, CM | 2
COM 9 FMALE | COM 9 | COM1 | DSB 9-F | DSB9F | 1
B560C-13-F | DIODE SCHOTTKY 60V 5A SMC | D1, D3 | DO-214AB SMC | D5A | 2
B340-13-F | DIODE SCHOTTKY 40V 3A SMC | D2 | DO-214AB SMA | D1A | 1
PWR_12V | LED Single colour Green and Red | D4 | LED-0805-Yellow | LED | 1
PWR_4V | LED Single colour Green and Red | D5 | LED-0805-Green | LED | 1
LED3mm | LED 2 holder RGB 3mm | D6, D7 | LED 2 holder 3mm | LED2Holder_3mm | 2
DIODE-BAV99 | ZENER, SOT23, | D8, D9, D12 | SOT23 | DIODE-BAV99 | 3
GPS | LED Single colour Green and Red | D10 | LED-0805-Red | LED | 1
1N5819 | Diode 1A | D11 | DO-214AB SMA | D1A_1 | 1
RKEF300HF-ND | PTC RESET FUSE 60V 3A RADIAL | F1 | FUSE2 | Fuse | 1
BLM21PG600SN1D | Ferrite Bead | FB1 | RES-SMD-0805 | Ferrite Bead | 1
BLM21PG600SN1D | Ferrite Bead | FB2, FB3, FB4 | R0805 | Ferrite Bead | 3
MAX232 | Dual EIA-232 Driver/Receiver | IC1 | MAX232DR | MAX232 | 1
DS18B20 | High Precision 1-Wire® Digital Thermometer | IC2 | TO92 | DS18S20 | 1
GPS_ANTENNA |  | J2, J4 | Antenna-MCX5.08-H5 | ANTEN | 2
SIM MICRO PUSH |  | J3 | MICROSIM_PUSH | SIM MICRO PUSH | 1
PWR | Header 4 (Green) | J5 | Hed4V_3.96 | Hed4 | 1
NPN_SENSOR | Connector 4 | J6 | CON_2.54mm_4 | Con4 | 1
V_IN | Connector 2 | J7 | CON_2.54mm_2 | Con2 | 1
DS18B20(1) | Header IDC, 3 x 1 Pin Vertical 2.54mm Pitch (Non-Boxed, Male) | J8 | Header3 | Header3 | 1
L | Inductor | L1 | L2 UF9.8 | L2x220 | 1
6.8uH | FIXED IND 6.2UH 5.7A 22.4 MOHM | L2 | L01 SMD 12*12*6 | L1 | 1
47nH | Inductor | L3 | RES-SMD-0805 | L1 | 1
100uH | 100uH 0805 | L4, L5, L6 | R0805 | Ferrite Bead | 3
OLED 1.3 |  | LCD1 | CON_4P | OLED 1.3 | 1
LED | LED Single colour Green and Red | LED1, LED2, LED3, LED4 | LED-0805-Green | LED | 4
SIM800C |  | M1 | SIM800C | SIM800C | 1
SD_CARD | SD/MMC holder | MicroSD | MICROSD2 | MicroSD | 1
C1815 | NPN 600mW, ECB | Q1, Q2, Q3, Q4, Q5, Q6 | SOT23B | C1815 | 6
10K | Resistor SMD | R1, R3, R7, R68, R73 | RES-SMD-0805 | RM | 5
22K | Resistor SMD | R2, R4 | RES-SMD-0805 | RM | 2
100K | Resistor SMD | R5, R8, R9, R36, R37 | RES-SMD-0805 | RM | 5
1K | Resistor SMD | R6, R13, R14, R15, R16, R17, R31, R34, R35, R38, R69 | RES-SMD-0805 | RM | 11
4.7K | Resistor SMD | R10, R70 | RES-SMD-0805 | RM | 2
47K | Resistor SMD | R11 | RES-SMD-0805 | RM | 1
4k7 | Resistor SMD | R12 | RES-SMD-0805 | RM | 1
1K | Resistor SMD, Resistor | R18, R58, R59, R60, R61, R62, R63, R64, R65 | RES-SMD-0603 | RM, Resistor - SMD | 9
10K | Resistor SMD | R19, R20, R22, R25, R26, R27, R48, R49, R50, R51, R52, R53, R54, R55, R56, R57 | R0603 -SMT | RM | 16
10R | Resistor SMD | R21, R23, R24 | RES-SMD-0603 | RM | 3
1K | Resistor SMD | R28, R30, R32, R44, R45 | R0603 -SMT | RM | 5
47K | Resistor SMD | R29, R46 | R0603 -SMT | RM | 2
4.7K | Resistor SMD | R33 | R0603 -SMT | RM | 1
51R | Resistor SMD | R39, R40, R41 | R0603 -SMT | RM | 3
0R | Resistor SMD | R42, R43 | R0603 -SMT | RM | 2
0R | Resistor SMD | R47 | RES-SMD-0805 | RM | 1
22R | Resistor SMD | R66, R67 | RES-SMD-0603 | RM | 2
1K 1% | Resistor SMD | R71 | RES-SMD-0805 | RM | 1
10K 1% | Resistor SMD | R72 | RES-SMD-0805 | RM | 1
RFID |  | RFID1 | RFID RC522 | RFID RC522 | 1
SW-SMD | Switch | S1 | SW-SMD | SW-SMD | 1
SW-SMD | Switch | S2, S3, S4 | BUTTON NGHIENG | SW-SMD | 3
ST_LINK | Header IDC, 4 x 1 Pin Vertical 2.54mm Pitch (Non-Boxed, Male) | ST_LINK | CON_4P | Header4 | 1
TLV70233DBVT |  | U1 | TLV70233_3.3V | TLV70233_3.3V | 1
TPS54360DDA | REG BUCK SPLIT RAIL 8SOPWRPAD | U2 | DDA8_3P1X2P4-M | TPS54360DDA | 1
TLV1117-33CDCYR | 3v3 | U3 | SOT223-4N | LM1117 | 1
LM7812SX/NOPB | LM7812SX/NOPB | U4 | TO-263-4 | LM78xx_1 | 1
78M05 | On ap +, from + 5 to + 24VDC | U5 | TO252-3L | LM78xx | 1
STM32F103RCT6 | MCU 32BIT 256KB FLASH 64LQFP | U6 | LQFP-64 | STM32F103RCT6 | 1
TPS3828 |  | U7 | TPS3828 | TPS3828 | 1
GPS L70 |  | U8 | GPS L70 | GPS L70 | 1
SMF05C | ESD Protection | U9, U12 | SOT_363_6 | SMF05C | 2
AT24C256 |  | U10 | SO-8 | AT24Cxx | 1
W25Q32JVSSIQ | FLASH 32MBIT 133MHZ 8SOP | U13 | SO-8 208 | W25Q32JV | 1
CH340G | High and Low Side Driver | U14 | SO16 | CH340G | 1
SRV05 | TVS DIODE 5V | U15 | SOT23-6 | SRV05 | 1
PC817 | Single Opto | U16 | PC817x1SMD | PC817 | 1
USB |  | USB1 | USB-B-Mini | USB-M | 1
32,768 Khz | Crystal 32,768kHz for timer real | X1 | XT32kn | XT32k | 1
8MHz | CRYSTAL 16MHZ 18PF SMD | Y1 | ABM7_v1_1_BIG | ABM7-16.000MHZ-D2Y-T | 1
12MHz | Crystal Oscillator | Y2 | XTAL-5032 | XTAL | 1
