Vanperdung/Mandevices_GPS_GSM/HARDWARE/MandevicesGPSGSM/Project Outputs for MandevicesGPSGSM/MandevicesGPSGSM.xlsx

Comment | Description | Designator | Footprint | LibRef | Quantity
Button 3x4x2.5 |  | B1, B2, B3, B4, B5 | Button 3x4x2.5 | Button 3x4x2.5 | 5
Pad Switch ON/OFF | Capacitor | C1 | CAP_3216 | CapSMD | 1
100nF | Capacitor | C2, C5, C6, C7, C8, C17, C21, C22, C23, C27, C28, C29 | CAP_0805 | CapSMD | 12
10uF | Capacitor | C3 | CAP_0805 | CapSMD | 1
LiPo Battery | Capacitor | C4 | CAP_0805 | CapSMD | 1
22pF | Capacitor | C9, C18, C20 | CAP_0805 | CapSMD | 3
1uF | Capacitor | C10, C13, C19, C25 | CAP_0805 | CapSMD | 4
10nF | Capacitor | C11, C12, C26 | CAP_0805 | CapSMD | 3
33pF | Capacitor | C14 | CAP_0805 | CapSMD | 1
10pF | Capacitor | C15 | CAP_0805 | CapSMD | 1
100uF | Polazied Tantalum Capacitor | C16 | CAP_7343 | CAP_TAN_SMD | 1
4.7uF | Capacitor | C24 | CAP_0805 | CapSMD | 1
Header 1.27mm |  | H1 | Header 1.27mm | Header 1.27mm | 1
RT9013 | RT9013-33GB IC REG LINEAR 3.3V 500mA SOT23-5 | IC1, IC2 | SOT23-5 | RT9013 | 2
USB-5 |  | J1 | USB-M1 | USB-5 | 1
LED 3mm | Cắm | L1 | LED-3MM 2 MAU | LED 3m 2 mau Anot chung | 1
47nH | Resistor | L2 | RES-SMD-0805 | Resistor - SMD | 1
LED | LED Single colour Green and Red | LED1, LED2 | LED-0805-Red | LED | 2
LED RED | LED Single colour Green and Red | LED3, LED6 | LED-0805-Red | LED | 2
LED YELLOW | LED Single colour Green and Red | LED4 | LED-0805-Red | LED | 1
LED GREEN | LED Single colour Green and Red | LED5 | LED-0805-Red | LED | 1
Speaker | Loudspeaker | LS1 | SPEAKER | Speaker | 1
Antenna | Antenna GSM GPS | P1, P2 | IPXS | IPXSx66 | 2
C1815 | NPN 600mW, ECB | Q1, Q2, Q3, Q4, Q5 | SOT23D | 2SC1815 | 5
0.4R | Resistor | R1 | RES-SMD-0805 | Resistor - SMD | 1
100R | Resistor | R2 | RES-SMD-0805 | Resistor - SMD | 1
1k | Resistor | R3, R5, R6, R11, R15, R20, R21, R37, R38, R39, R40 | RES-SMD-0805 | Resistor - SMD | 11
1.2k | Resistor | R4 | RES-SMD-0805 | Resistor - SMD | 1
51R | Resistor | R7, R8, R10 | RES-SMD-0805 | Resistor - SMD | 3
4.7k | Resistor | R9, R13, R17, R24, R29 | RES-SMD-0805 | Resistor - SMD | 5
47k | Resistor | R12, R14, R18, R25, R30 | RES-SMD-0805 | Resistor - SMD | 5
10k | Resistor | R16, R28, R32, R33, R34, R36 | RES-SMD-0805 | Resistor - SMD | 6
5.6k | Resistor | R19 | RES-SMD-0805 | Resistor - SMD | 1
0R | Resistor | R22, R23, R27 | RES-SMD-0805 | Resistor - SMD | 3
10R | Resistor | R26 | RES-SMD-0805 | Resistor - SMD | 1
100k | Resistor | R31 | RES-SMD-0805 | Resistor - SMD | 1
22k | Resistor | R35 | RES-SMD-0805 | Resistor - SMD | 1
SIM SOCKET 6P |  | SIM1 | SIM SOCKET 6P | SIM SOCKET 6P | 1
TP4056 | Complete single cell Li-Ion battery with a constant current / constant voltage linear charger | U1 | TP4056 | TP4056 | 1
DW01A | One Cell Lithium-ion/Polymer Battery Protection IC | U2 | SOT23-6 | DW01A | 1
FS8205A |  | U3 | FS8205A | FS8205A | 1
CH340C | USB to serial chip CH340 | U4 | SO016 | CH340C | 1
SIM800C | Module: GSM/Bluetooth; GPRS; 2G; 1800MHz, 900MHz; 85.6kbps; SMD | U5 | LCC110P1570X1760X250-42N | SIM800C | 1
L70-RL | L70-RL, a low cost ROM-based GPS module, brings the high performance of MTK positioning engine to industrial applications with its compact profile, ultra low power consumption and fast positioning capability | U6 | XCVR_L70-RL | L70-RL | 1
STM32 | STM32 ARM-based 32-bit MCU with 64 Kbytes Flash, 64-pin LQFP, Industrial Temperature | U7 | LQFP 48 | STM32F103C8T6 | 1
8Mhz | Crystal For all Crystal 2pin. | Y1 | Thach Anh 2 chan SMD5032 | Thach Anh 2 chan SMD 5032 | 1
