Vanperdung/Mandevices_GPS_GSM/Document/DATN-master/Test Result/LOCATION15062021_TEST2.csv

lat | lng | name | color | note
20.99211696 | 105.8021774 |  | #ff0000
20.99205784 | 105.802124 |  | #ff0000
20.9921112 | 105.8021393 |  | #ff0000
20.99201008 | 105.8022079 |  | #ff0000
20.99197576 | 105.8024216 |  | #ff0000
20.9918308 | 105.8027267 |  | #ff0000
20.99143032 | 105.8029556 |  | #ff0000
20.99152376 | 105.803566 |  | #ff0000
20.99173928 | 105.8039093 |  | #ff0000
20.99197384 | 105.8042145 |  | #ff0000
20.99224088 | 105.8046036 |  | #ff0000
20.99248504 | 105.8049774 |  | #ff0000
20.99270248 | 105.8053055 |  | #ff0000
20.99285696 | 105.8056488 |  | #ff0000
20.99302672 | 105.8059387 |  | #ff0000
20.99329184 | 105.8062058 |  | #ff0000
20.99354744 | 105.806488 |  | #ff0000
20.99378584 | 105.8067932 |  | #ff0000
20.99401472 | 105.8070907 |  | #ff0000
20.99424168 | 105.8074036 |  | #ff0000
20.99447056 | 105.8077164 |  | #ff0000
20.9946976 | 105.8080292 |  | #ff0000
20.9949188 | 105.8083496 |  | #ff0000
20.99513816 | 105.8086777 |  | #ff0000
20.99535752 | 105.8089981 |  | #ff0000
20.9955788 | 105.8093262 |  | #ff0000
20.9958 | 105.8096466 |  | #ff0000
20.99602128 | 105.8099746 |  | #ff0000
20.99624256 | 105.8103027 |  | #ff0000
20.99646376 | 105.8106232 |  | #ff0000
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
