Vanperdung/Mandevices_GPS_GSM/HARDWARE/MandevicesGPSGSM/MandevicesGPSGSM.pdf

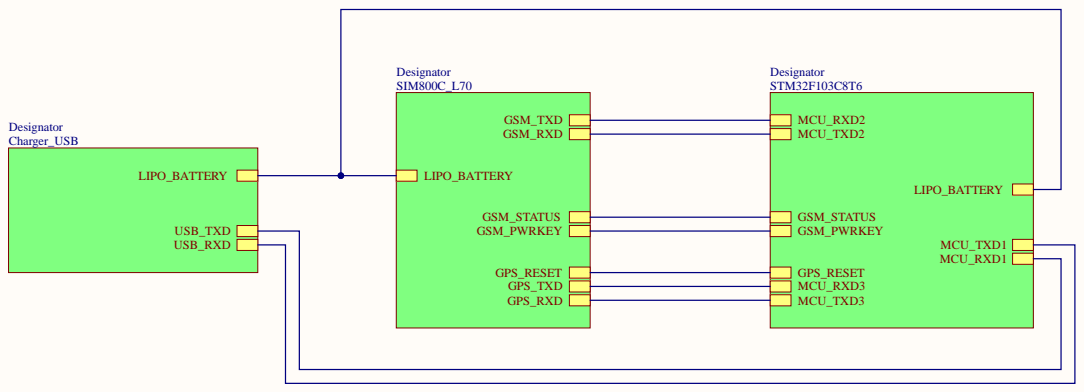
[picture p4: page 1]

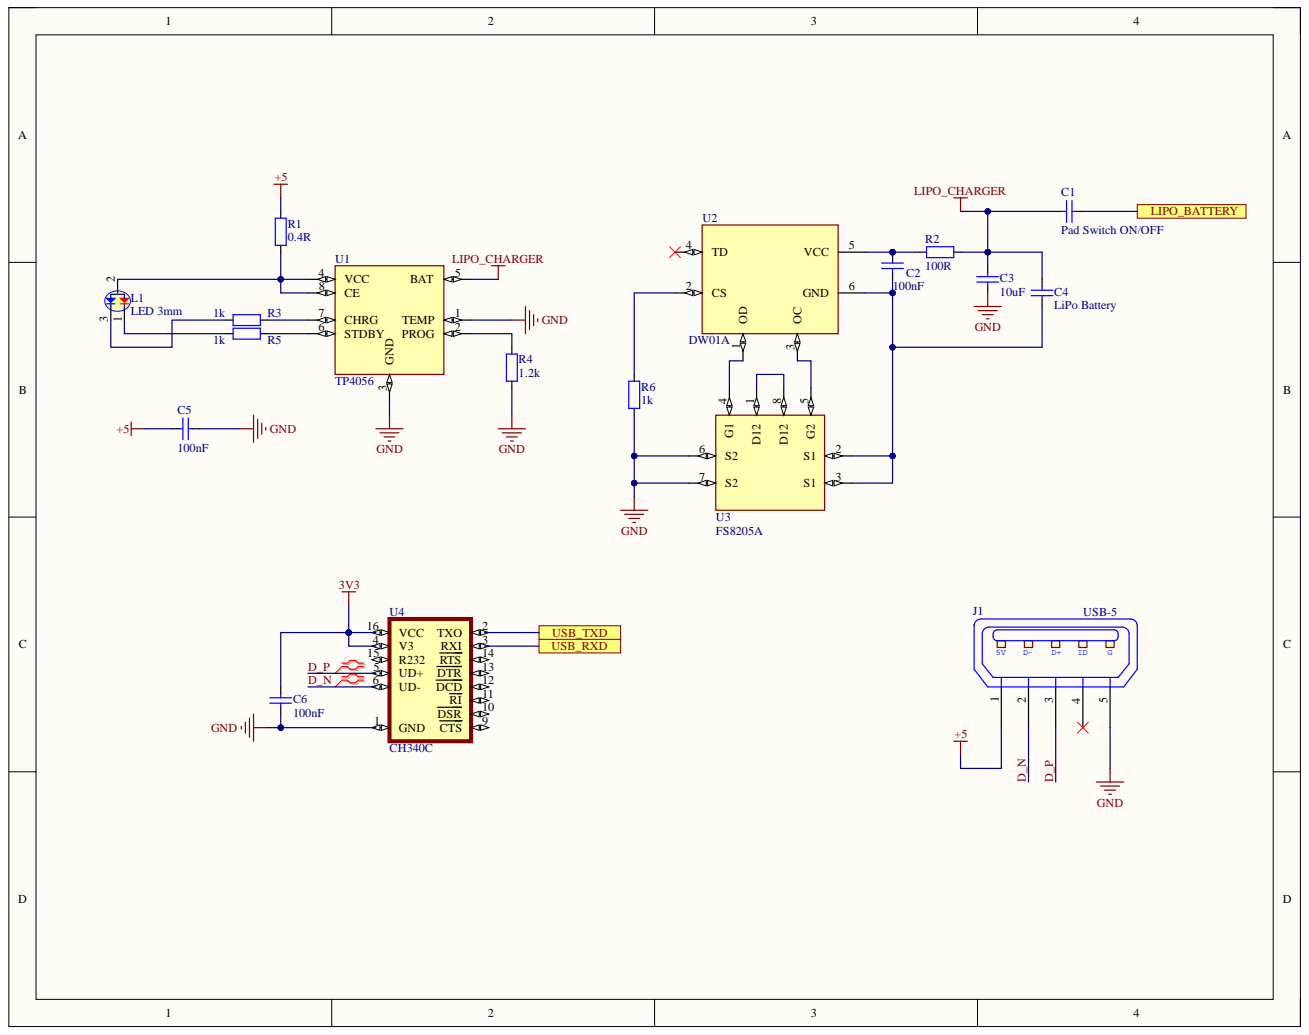
[picture p5: page 2]

Pad Switch ON/OFF R1

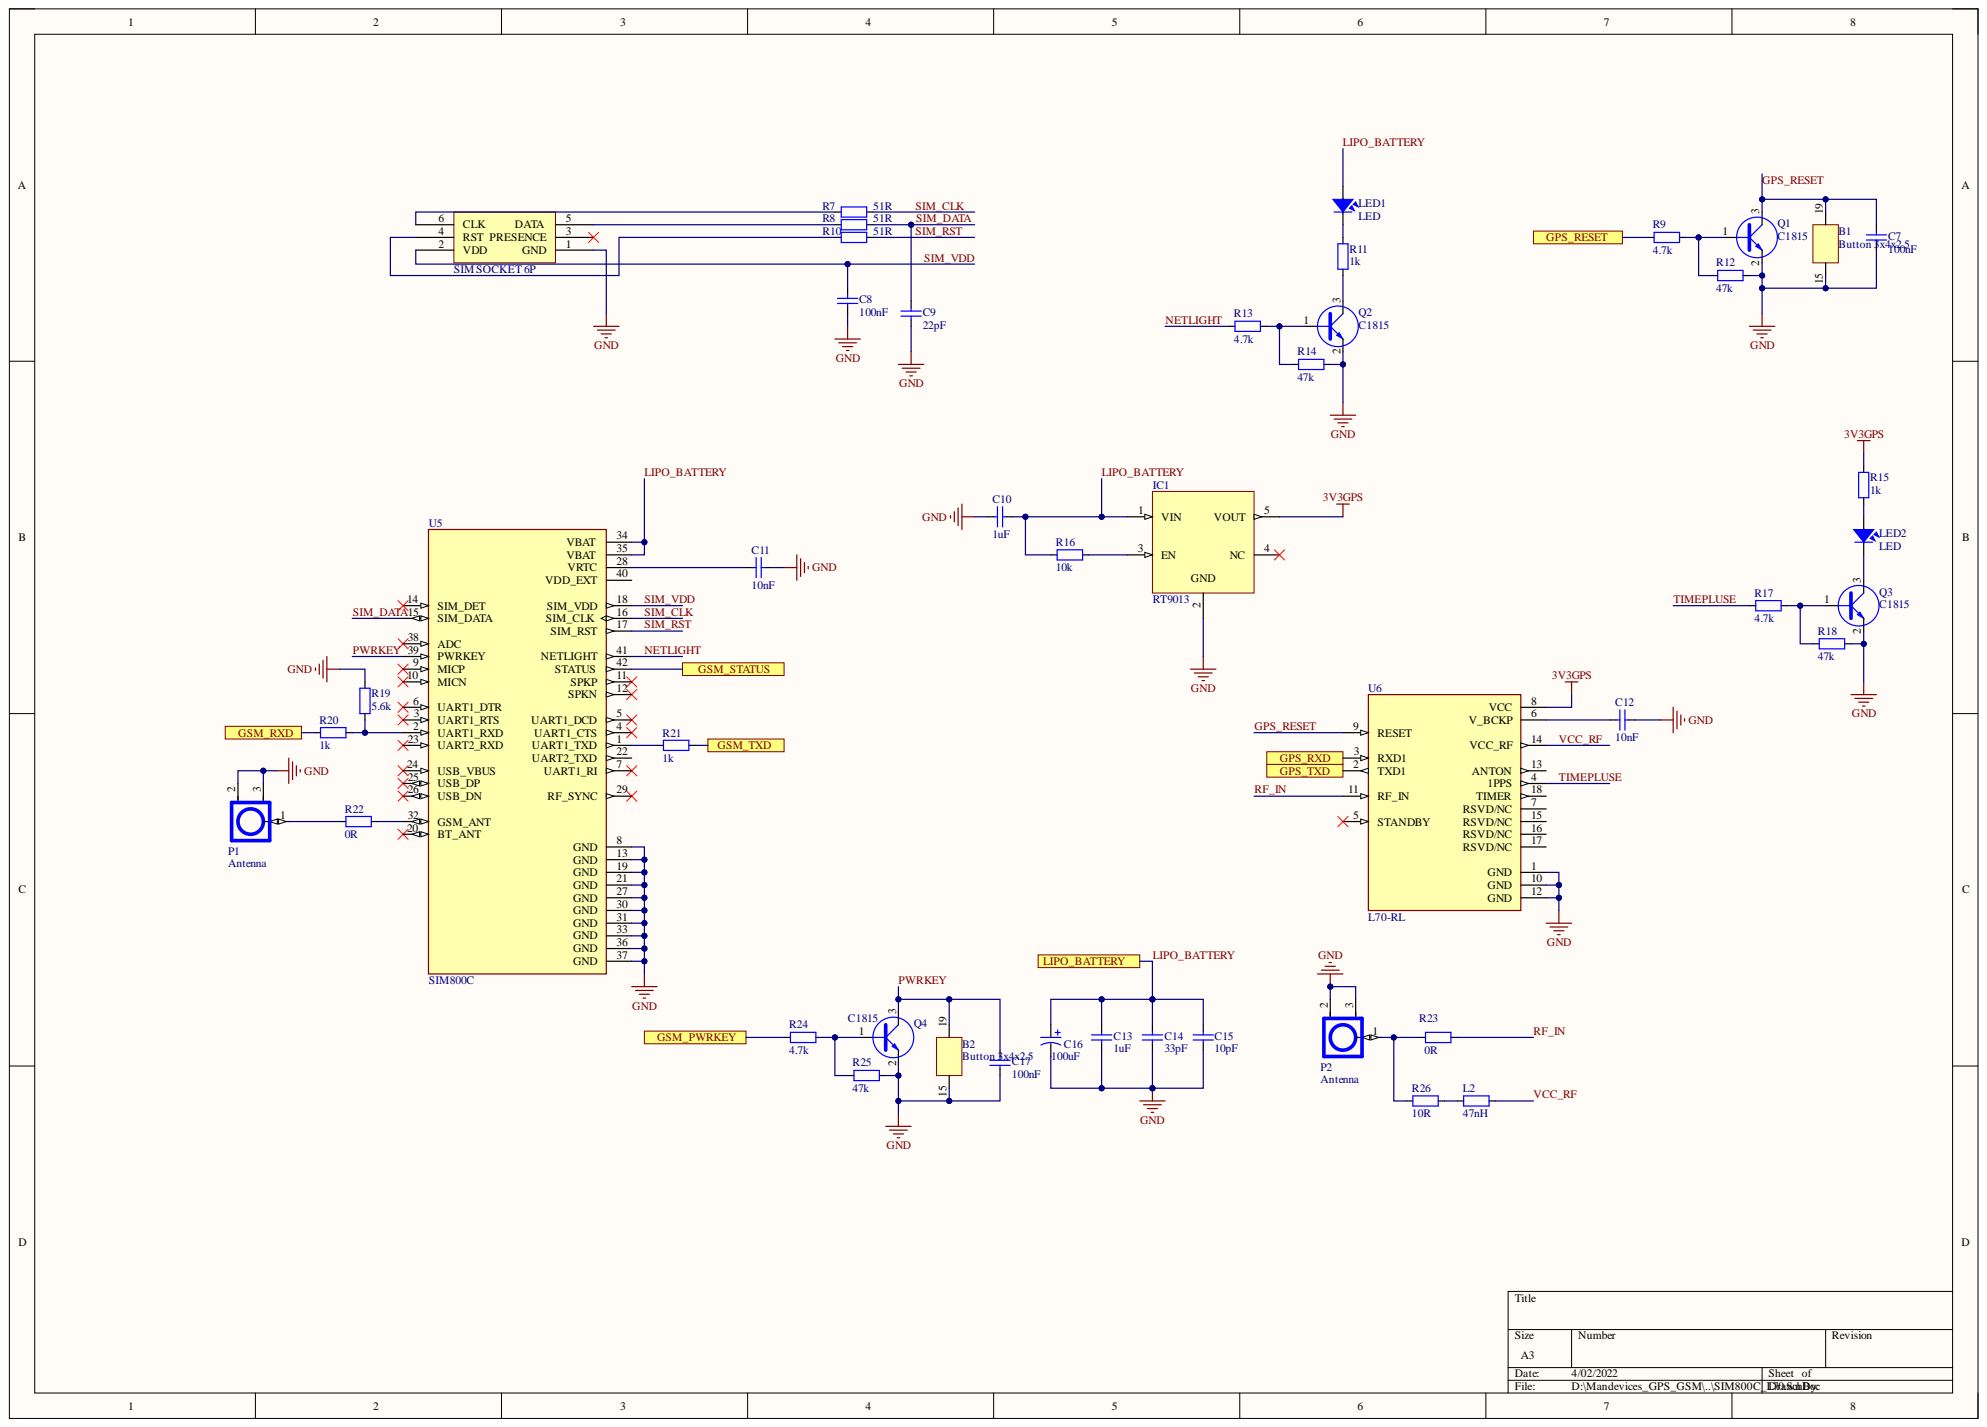
[picture p6: page 3]

GPS_RXD | TXD1 2

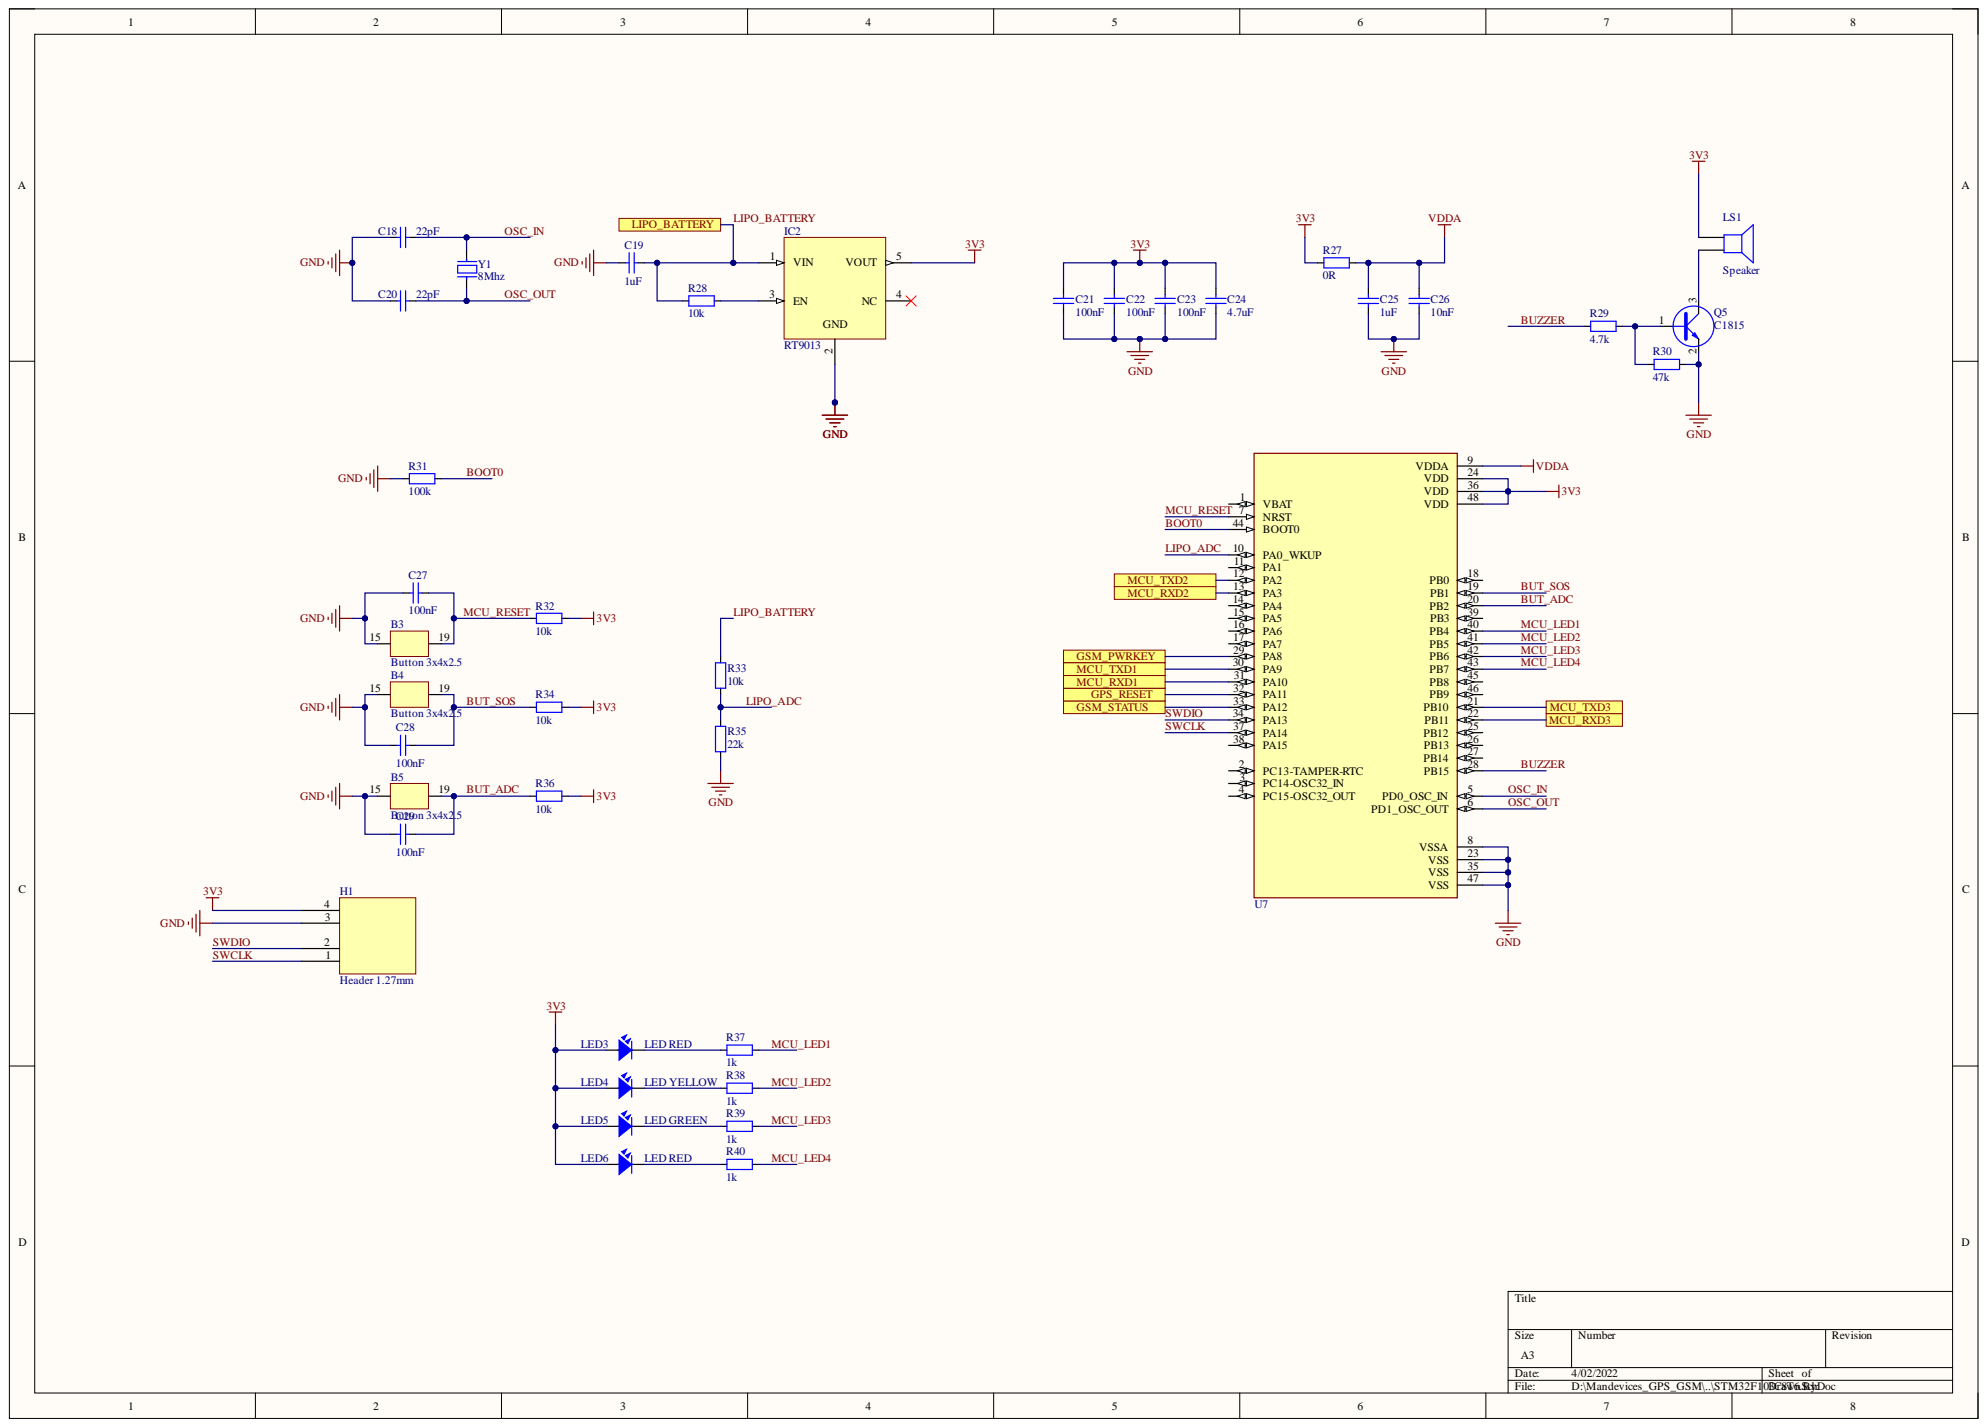
[picture p7: page 4]

MCU_RXD2 | PA3 13

MCU_TXD1 | PA9 30
MCU_RXD1 | PA10 31

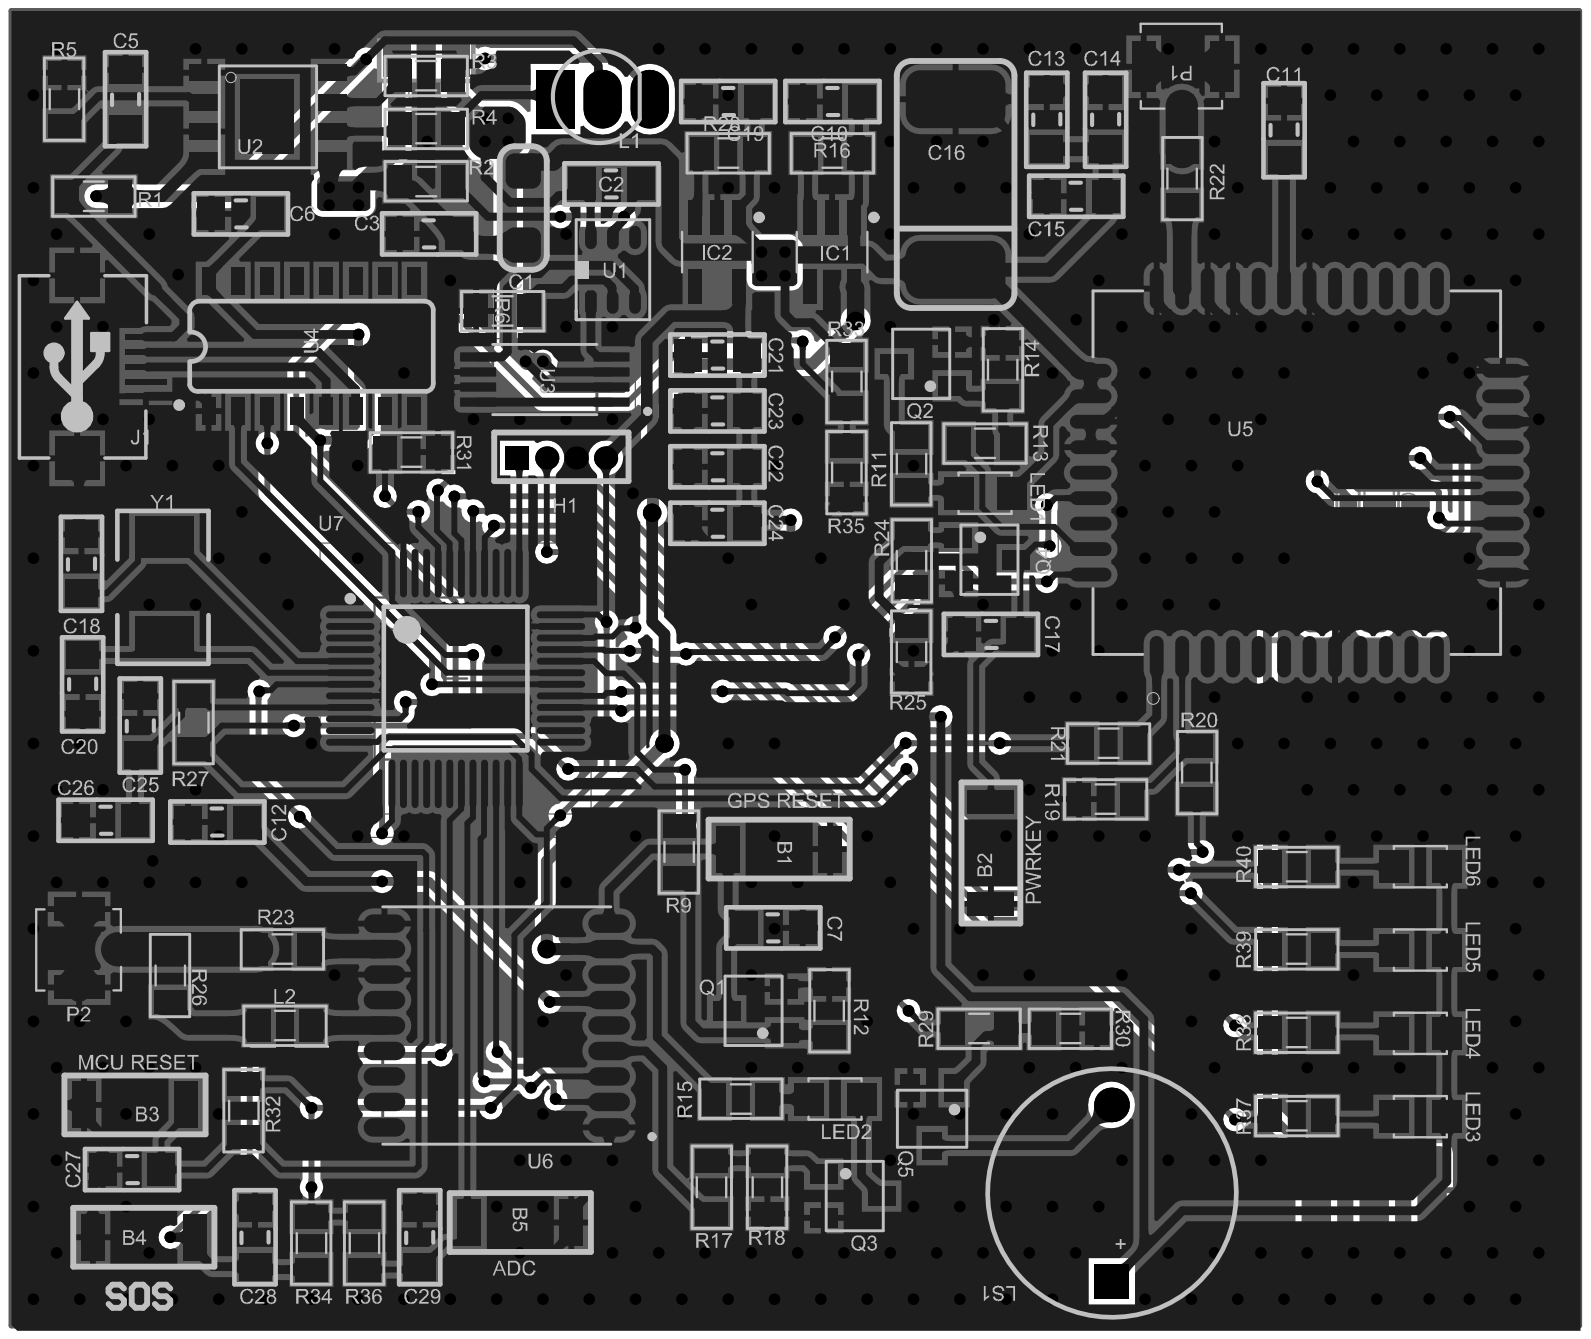
[picture p8: page 5]
