Vanperdung/Mandevices_GPS_GSM/(list of files, drawings)

Other design files:
Document/DATN-master/PCB/TrackingGPS/[01] Power Suppy.SchDoc
Document/DATN-master/PCB/TrackingGPS/[02] MCU.SchDoc
Document/DATN-master/PCB/TrackingGPS/[03] GSM_GPRS_GPS.SchDoc
Document/DATN-master/PCB/TrackingGPS/[04] EEPROM_FLASH.SchDoc
Document/DATN-master/PCB/TrackingGPS/[05] RTC_RS232_USB.SchDoc
Document/DATN-master/PCB/TrackingGPS/[06] IN_OUT_SENSOR.SchDoc
Document/DATN-master/PCB/TrackingGPS/[07] RFID_LCD.SchDoc
Document/DATN-master/PCB/TrackingGPS/GPS_Tracking_V1.0.SchDoc
Document/DATN-master/PCB/TrackingGPS/Tracking_GPS_V1.0.PrjPCB
Document/DATN-master/PCB/TrackingGPSV1_1/[01] Power Suppy.SchDoc
Document/DATN-master/PCB/TrackingGPSV1_1/[02] MCU.SchDoc
Document/DATN-master/PCB/TrackingGPSV1_1/[03] GSM_GPRS_GPS.SchDoc
Document/DATN-master/PCB/TrackingGPSV1_1/[04] EEPROM_FLASH.SchDoc
Document/DATN-master/PCB/TrackingGPSV1_1/[05] RTC_RS232_USB.SchDoc
Document/DATN-master/PCB/TrackingGPSV1_1/[06] IN_OUT_SENSOR.SchDoc
Document/DATN-master/PCB/TrackingGPSV1_1/[07] RFID_LCD.SchDoc
Document/DATN-master/PCB/TrackingGPSV1_1/GPS_Tracking_V1.0.SchDoc
Document/DATN-master/PCB/TrackingGPSV1_1/Tracking_GPS_V1.0.PrjPCB
Document/DATN-master/PCB/TrackingGPSV1_4/[01]PowerSupply.SchDoc
Document/DATN-master/PCB/TrackingGPSV1_4/[02]MCU.SchDoc
Document/DATN-master/PCB/TrackingGPSV1_4/[03]GSM_GPRS_GPS.SchDoc
Document/DATN-master/PCB/TrackingGPSV1_4/[04]EEPROM_FLASH.SchDoc
Document/DATN-master/PCB/TrackingGPSV1_4/[05]RS232_USB.SchDoc
Document/DATN-master/PCB/TrackingGPSV1_4/[06]IN_OUT.SchDoc
Document/DATN-master/PCB/TrackingGPSV1_4/[07]RFID_LCD.SchDoc
Document/DATN-master/PCB/TrackingGPSV1_4/GSHT_V1.4.PrjPCB
Document/DATN-master/PCB/TrackingGPSV1_4/GSHT_V1.4.SchDoc
Document/DATN-master/PCB/V1.4 backup/[01]PowerSupply.SchDoc
Document/DATN-master/PCB/V1.4 backup/[02]MCU.SchDoc
Document/DATN-master/PCB/V1.4 backup/[03]GSM_GPRS_GPS.SchDoc
Document/DATN-master/PCB/V1.4 backup/[04]EEPROM_FLASH.SchDoc
Document/DATN-master/PCB/V1.4 backup/[05]RS232_USB.SchDoc
Document/DATN-master/PCB/V1.4 backup/[06]IN_OUT.SchDoc
Document/DATN-master/PCB/V1.4 backup/[07]RFID_LCD.SchDoc
Document/DATN-master/PCB/V1.4 backup/GSHT_V1.4.PrjPCB
Document/DATN-master/PCB/V1.4 backup/GSHT_V1.4.SchDoc
HARDWARE/MandevicesGPSGSM/Charger_USB.SchDoc
HARDWARE/MandevicesGPSGSM/MandevicesGPSGSM.PrjPcb
HARDWARE/MandevicesGPSGSM/Sheet1.SchDoc
HARDWARE/MandevicesGPSGSM/SIM800C_L70.SchDoc
HARDWARE/MandevicesGPSGSM/STM32F103C8T6.SchDoc
