Vanperdung/Mandevices_GPS_GSM/Firmware/Mandevices_GPS_GSM/Core/Src/main.c

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
/* Includes ------------------------------------------------------------------*/
#include "main.h"
#include "adc.h"
#include "tim.h"
#include "usart.h"
#include "gpio.h"

/* USER CODE BEGIN Includes */
#include <stdio.h>
#include <string.h>
#include <stdlib.h>
#include <math.h>
#include "sim800c.h"
#include "l70.h"
/* USER CODE END Includes */


/* USER CODE BEGIN PV */
// char data[100];
bool SOSFlag = false;
char simNumber[20] = "0778554218";
char latData[15] = {0};
char longData[15] = {0};
char simMessage[500] = {0};
char *GPSResponse;
uint16_t ADC_value;
/* USER CODE END PV */

void SystemClock_Config(void);
/* USER CODE BEGIN 0 */

void HAL_UART_RxCpltCallback(UART_HandleTypeDef *huart)
{
  if(huart == &huart2)
  {
    sim800c_callback();
  }
  if(huart == &huart3)
  {
    l70_callback();
  }
}

void HAL_TIM_PeriodElapsedCallback(TIM_HandleTypeDef *htim)
{
  if(htim == &htim2)
  {
    sim800c_timerCallback();
  }
  else if(htim == &htim1)
  {
    HAL_GPIO_WritePin(GPIOB, GPIO_PIN_4, GPIO_PIN_SET);
    HAL_GPIO_WritePin(GPIOB, GPIO_PIN_5, GPIO_PIN_SET);
    HAL_GPIO_WritePin(GPIOB, GPIO_PIN_6, GPIO_PIN_SET);
    HAL_GPIO_WritePin(GPIOB, GPIO_PIN_7, GPIO_PIN_SET);
    HAL_TIM_Base_Stop_IT(&htim1);
  }
}

void HAL_GPIO_EXTI_Callback(uint16_t GPIO_Pin)
{
  if (GPIO_Pin == BUT_ADC_Pin)
  {
    ADC_value = HAL_ADC_GetValue(&hadc1);
    // >4.1V
    if (ADC_value > 3057) 
    {
      HAL_GPIO_WritePin(GPIOB, GPIO_PIN_4, GPIO_PIN_RESET);
      HAL_GPIO_WritePin(GPIOB, GPIO_PIN_5, GPIO_PIN_RESET);
      HAL_GPIO_WritePin(GPIOB, GPIO_PIN_6, GPIO_PIN_RESET);
      HAL_GPIO_WritePin(GPIOB, GPIO_PIN_7, GPIO_PIN_RESET);
    }
    // 3.7-4.1V  
    else if (ADC_value <= 3057 && ADC_value > 2817)    
    {
      HAL_GPIO_WritePin(GPIOB, GPIO_PIN_4, GPIO_PIN_SET);
      HAL_GPIO_WritePin(GPIOB, GPIO_PIN_5, GPIO_PIN_RESET);
      HAL_GPIO_WritePin(GPIOB, GPIO_PIN_6, GPIO_PIN_RESET);
      HAL_GPIO_WritePin(GPIOB, GPIO_PIN_7, GPIO_PIN_RESET);
    }
    // 3.3->3.7V
    else if (ADC_value <= 2817 && ADC_value > 2705)
    {
      HAL_GPIO_WritePin(GPIOB, GPIO_PIN_4, GPIO_PIN_SET);
      HAL_GPIO_WritePin(GPIOB, GPIO_PIN_5, GPIO_PIN_SET);
      HAL_GPIO_WritePin(GPIOB, GPIO_PIN_6, GPIO_PIN_RESET);
      HAL_GPIO_WritePin(GPIOB, GPIO_PIN_7, GPIO_PIN_RESET);
    }
    // 0->3.3V
    else if (ADC_value <= 2705)
    {
      HAL_GPIO_WritePin(GPIOB, GPIO_PIN_4, GPIO_PIN_SET);
      HAL_GPIO_WritePin(GPIOB, GPIO_PIN_5, GPIO_PIN_SET);
      HAL_GPIO_WritePin(GPIOB, GPIO_PIN_6, GPIO_PIN_SET);
      HAL_GPIO_WritePin(GPIOB, GPIO_PIN_7, GPIO_PIN_RESET);
    }
    TIM1->CNT = 0;
    HAL_TIM_Base_Start_IT(&htim1);
  }
  else if (GPIO_Pin == BUT_SOS_Pin)
  {
    SOSFlag = true;
    HAL_GPIO_WritePin(MCU_BUZZER_GPIO_Port, MCU_BUZZER_Pin, GPIO_PIN_SET);
  }
}

/* USER CODE END 0 */

/**
  * @brief  The application entry point.
  * @retval int
  */
int main(void)
{
  /* USER CODE BEGIN 1 */
  uint32_t timeStart = 0;
  uint32_t timeCurrent = 0;

  // Test GPS Tracking
  // char GPSTest[4000] = {0};
  // int GPSTestIndex = 0;
  // int len = 0;
  /* USER CODE END 1 */

  /* MCU Configuration--------------------------------------------------------*/

  /* Reset of all peripherals, Initializes the Flash interface and the Systick. */
  HAL_Init();

  /* Configure the system clock */
  SystemClock_Config();

  /* Initialize all configured peripherals */
  MX_GPIO_Init();
  MX_ADC1_Init();
  MX_USART2_UART_Init();
  MX_USART3_UART_Init();
  MX_USART1_UART_Init();
  MX_TIM2_Init();
  MX_TIM1_Init();
  /* USER CODE BEGIN 2 */
  HAL_ADC_Start(&hadc1);
  timeStart = HAL_GetTick();
  while(HAL_GPIO_ReadPin(GSM_STATUS_GPIO_Port, GSM_STATUS_Pin) == GPIO_PIN_RESET)
  {
    HAL_GPIO_WritePin(GSM_PWRKEY_GPIO_Port, GSM_PWRKEY_Pin, SET);
    HAL_Delay(1000);
  }
  sim800c_init();
  HAL_Delay(100);
  l70_init();
  HAL_Delay(100);
  HAL_UART_Transmit_IT(&huart2, (uint8_t*)"AT+HTTPINIT\r\n", strlen("AT+HTTPINIT\r\n"));  
  HAL_Delay(1000);
  // do
  // {
  //   GPSResponse = l70_receiveGPS();
  //   l70_handleGPS(latData, longData, GPSResponse);
  //   sprintf(simMessage, "https://www.google.com/maps/search/?api=1&query=%s,%s\n", latData, longData);
  //   HAL_UART_Transmit(&huart1, (uint8_t*)simMessage, 100, 200);
  //   HAL_Delay(5000);
  // } while (((strstr(latData, ".000000") != NULL) && (strstr(longData, ".000000") != NULL)));

  /* USER CODE END 2 */

  /* Infinite loop */
  /* USER CODE BEGIN WHILE */
  while(1)
  {
    /* USER CODE END WHILE */

    /* USER CODE BEGIN 3 */
    if(SOSFlag == true)
    {
      HAL_GPIO_WritePin(MCU_BUZZER_GPIO_Port, MCU_BUZZER_Pin, SET);
      timeCurrent = HAL_GetTick();
      if(timeCurrent - timeStart > 3000)
      {
        timeStart = timeCurrent;
        HAL_UART_Transmit(&huart1, (uint8_t*)"Bat dau gui tin nhan\r\n", strlen("Bat dau gui tin nhan\r\n"), 100);
        GPSResponse = l70_receiveGPS();
        HAL_GPIO_WritePin(MCU_BUZZER_GPIO_Port, MCU_BUZZER_Pin, RESET); 
        l70_handleGPS(latData, longData, GPSResponse);
        sprintf(simMessage, "https://www.google.com/maps/search/?api=1&query=%s,%s\n", latData, longData);
        sim800c_sendSMS(latData, longData, simNumber, simMessage);
        memset(simMessage, '\0', sizeof(simMessage));
        SOSFlag = false;
      }
      else
      {
        HAL_UART_Transmit(&huart1, (uint8_t*)"Doi mot luc\r\n", strlen("Doi mot luc\r\n"), 100);
        SOSFlag = false;
        HAL_GPIO_WritePin(MCU_BUZZER_GPIO_Port, MCU_BUZZER_Pin, RESET); 
      }
    }

    if(HAL_GetTick() - timeStart > 10000)
    {
      HAL_GPIO_WritePin(MCU_BUZZER_GPIO_Port, MCU_BUZZER_Pin, SET);
      timeStart = HAL_GetTick();
      GPSResponse = l70_receiveGPS();
      HAL_GPIO_WritePin(MCU_BUZZER_GPIO_Port, MCU_BUZZER_Pin, RESET);
      l70_handleGPS(latData, longData, GPSResponse);
      sprintf(simMessage, "AT+HTTPPARA=URL,\"http://demo2.traccar.org:5055/?id=gps2001&lat=%s&lon=%s&battery=%s\"\r\n", latData, longData, battery);
      HAL_UART_Transmit_IT(&huart2, (uint8_t*)simMessage, strlen(simMessage));
      HAL_Delay(3000);
      HAL_UART_Transmit_IT(&huart2, (uint8_t*)"AT+HTTPACTION=1\r\n", strlen("AT+HTTPACTION=1\r\n"));
      HAL_Delay(4000);
    }

    // Test GPS Tracking
    // timeCurrent = HAL_GetTick();
    // if(timeCurrent - timeStart > 5000)
    // {
    //   HAL_GPIO_WritePin(MCU_BUZZER_GPIO_Port, MCU_BUZZER_Pin, SET); 
    //   timeStart = timeCurrent;
    //   GPSResponse = l70_receiveGPS();
    //   l70_handleGPS(latData, longData, GPSResponse);
    //   sprintf(simMessage, "{ lat: %s, lng: %s },\n", latData, longData);
    //   len = strlen(simMessage);
    //   memcpy(GPSTest + len * GPSTestIndex, simMessage, len);
    //   GPSTestIndex++;
    //   if(GPSTestIndex == 10)
    //   {
    //     sim800c_sendSMS(latData, longData, simNumber, GPSTest);
    //     GPSTestIndex = 0;
    //   }
    // }
    // HAL_GPIO_WritePin(MCU_BUZZER_GPIO_Port, MCU_BUZZER_Pin, RESET); 

    
  }
  /* USER CODE END 3 */
}

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
